OPbagelBites/ECEN404-2026SP-Home-Power-Monitor-2/docs/Drawboard-Combined.docx

Ohm Sweet Home

Joshua Le

Lawson Parr

Kim Peteros

Caiden Rueben

Vivek Samuel

CONCEPT OF OPERATIONS

REVISION – A

September 9, 2025

CONCEPT OF OPERATIONS

FOR

Ohm Sweet Home

TEAM OHM SWEET HOME

APPROVED BY:

_____________________________ Kim Peteros Date _____________________________ Prof. Kalafatis Date _____________________________ Vishwam Raval Date

Concept of Operations Revision - A

Ohm Sweet Home

Change Record

Rev . | Date | Originator | Approvals | Description
1 | 9/9/2025 | Kim Peteros | | Draft Release

2

Concept of Operations Revision - A

Ohm Sweet Home

Table of Contents

Table of Contents.........................................................................................................................3 List of Figures..............................................................................................................................4 1. Executive Summary..........................................................................................................5 1. Introduction....................................................................................................................... 5

1.1. Background......................................................................................................................6 1.2. Overview.......................................................................................................................... 7 1.3. Referenced Documents and Standards............................................................................8

2. Operating Concept............................................................................................................9 2.1. Scope................................................................................................................................ 9 2.2. Operational Description and Constraints................................................................. 11 2.3. System Description.......................................................................................................12 2.4. Modes of Operations................................................................................................... 13 2.5. Users...............................................................................................................................15 2.6. Support...........................................................................................................................17

3. Scenario(s)...................................................................................................................... 18 4. Analysis........................................................................................................................... 20 4.1. Summary of Proposed Improvements...................................................................... 20 4.2. Disadvantages and Limitations...................................................................................21 4.3. Alternatives....................................................................................................................21 4.4. Impact.............................................................................................................................21

3

Concept of Operations Revision - A

Ohm Sweet Home

List of Figures

Figure 1: Home Power Monitor Systems Block Diagram..................................................7 Figure 2: Home Power Monitor Installation......................................................................15

4

Concept of Operations Revision - A

Ohm Sweet Home

1. Executive Summary

The Home Power Monitor is a cost-effective system that provides homeowners with actionable, device-level insights into their electricity usage. As energy costs rise, our solution helps users understand exactly which devices are driving demand. The system integrates five subsystems: an Analog Front End (AFE) to capture electrical signals, a PCB to house the hardware, Digital Signal Processing (DSP) to extract key features, Machine Learning (ML) to identify individual appliances, and a Mobile App for real-time monitoring. By combining precise sensing with advanced analytics, our monitor empowers users to reduce energy waste and lower their utility bills.

1. Introduction

Household electricity consumption drives both utility costs and environmental impact. While most homes have smart meters or utility monitoring, these typically provide only aggregate usage data, offering little insight into which appliances consume the most energy. As a result, opportunities for savings, efficiency, and sustainability often go unrealized.

The Home Power Monitor project addresses this gap by designing a system that measures, analyzes, and classifies energy use at a more granular level. Using affordable sensors, embedded signal processing, machine learning, and a user-friendly app, the system monitors total household consumption and attributes usage to specific devices in near real time.

This interdisciplinary project integrates multiple subsystems: the Analog Front End (AFE) conditions sensor signals, PCB Management combines power and communication hardware, the DSP subsystem extracts features like rms voltage/current, power, and harmonics, and the Machine Learning subsystem identifies devices. Finally, the Application Development subsystem delivers actionable insights through a mobile interface.

Motivated by rising energy costs and sustainability concerns, the Home Power Monitor demonstrates the feasibility of detailed energy monitoring with low-cost components, offering immediate user value and a scalable path toward smart-grid integration.

5

Concept of Operations Revision - A

Ohm Sweet Home

1.1. Background

Current residential energy monitoring is typically limited to whole-home smart meters provided by utility companies. While these devices record total consumption and may allow for daily or hourly breakdowns, they do not provide appliance-level visibility. As a result, users are often left guessing which devices contribute most to their utility bill, reducing the effectiveness of conservation efforts.

Some aftermarket energy monitors exist on the consumer market; however, they are often expensive, closed-source, or rely on proprietary ecosystems that limit flexibility. In addition, many of these products require invasive installation or lack robust analytics, making them inaccessible to the average household.

The Home Power Monitor project is designed to enhance these limitations by delivering a system that is:

● More informative – Using digital signal processing and machine learning, the system provides detailed insights at the device level rather than only whole-home usage.

● More accessible – The design emphasizes low-cost components, a modular PCB, and straightforward installation at the electrical panel.

● More adaptable – By generating standardized JSON data streams and a custom mobile application, the system can evolve beyond monitoring to integrate with future smart home or grid-interactive technologies.

In essence, the proposed project enhances existing monitoring by adding device detection, advanced analytics, and a user-centric interface while replacing the need for costly commercial solutions. It bridges the gap between simple utility data and full smart-home energy management, giving households a practical tool to reduce waste and make informed energy decisions.

6

Concept of Operations Revision - A

Ohm Sweet Home

1.2. Overview

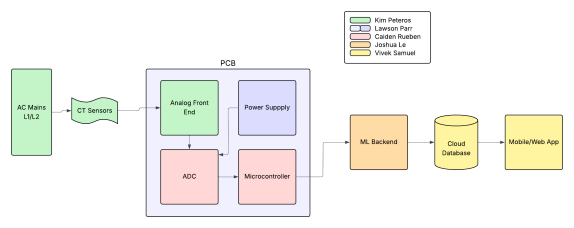
[picture p14: figure]

Figure 1: Home Power Monitor System Block Diagram

The Home Power Monitor is a multidisciplinary system that combines sensing hardware, embedded processing, intelligent analytics, and user-facing software to provide household residents with actionable insight into their energy consumption. The system is organized into five subsystems, Analog Front End (AFE), PCB Management, Digital Signal Processing (DSP), Machine Learning (ML), and Application Development, which work together to deliver accurate data collection, advanced analysis, and a user-friendly interface.

At the foundation of the system, the Analog Front End (AFE) acquires raw current and voltage signals directly from the household electrical panel. Current transformers (CTs) measure line currents, while voltage dividers or isolation sensors capture the corresponding voltage waveforms. These signals are conditioned through filtering, scaling, and isolation circuitry to ensure safety and fidelity before digitization.

The PCB Management subsystem provides the physical integration platform for the project. It consolidates the AFE, microcontroller, power supply, and wireless communication

hardware onto a single, custom-designed printed circuit board. By managing the hardware interconnections, this subsystem ensures reliability, compactness, and scalability. It also simplifies the installation process for end users by housing multiple sensing and processing elements in a single unit.

7

Concept of Operations Revision - A

Ohm Sweet Home

Once the analog signals are digitized, the DSP subsystem takes responsibility for extracting meaningful features. Algorithms implemented on the microcontroller compute metrics such as RMS voltage and current, instantaneous power, real and reactive power, power factor, and harmonic distortion. The DSP subsystem also performs windowing and spectral analysis to capture the load signatures needed for device-level identification. These outputs are structured into JSON-formatted data packets, ensuring consistency for downstream processing and external applications.

The Machine Learning (ML) subsystem processes the feature sets generated by DSP to identify and classify individual appliances. By leveraging training datasets of common load signatures, the ML algorithms can distinguish devices such as refrigerators, HVAC units, or lighting systems, even when they operate simultaneously. Over time, the ML models can be refined and retrained to improve accuracy, adapt to new devices, and accommodate variations in household electrical environments.

The final subsystem, Application Development, focuses on delivering insights to the end user through a mobile or web-based application. This interface displays total household consumption, disaggregated device-level usage, power quality metrics, and historical trends. Users can interact with the data visually through graphs, charts, and notifications, allowing them to identify inefficiencies, track costs, and make informed decisions about their energy usage. The app also serves as the bridge between technical system outputs and practical consumer utility.

Together, these subsystems form a modular yet tightly integrated architecture. The hardware and PCB components enable safe and reliable data collection, the DSP and ML subsystems transform raw measurements into actionable intelligence, and the app development subsystem ensures accessibility and ease of use. This layered approach allows the Home Power Monitor to be more informative, affordable, and adaptable than existing consumer energy monitoring solutions, while maintaining a clear structure that supports future enhancements such as smart-home integration or utility-side data sharing.

1.3. Referenced Documents and Standards

The Home Power Monitor project aligns with relevant electrical, communication, and data standards to ensure safe operation, reliable performance, and interoperability. The following documents and standards have been considered:

● IEEE Standards

○ IEEE Std 1459-2010: Definitions for the Measurement of Electric Power Quantities Under Sinusoidal, Non-Sinusoidal, Balanced, or Unbalanced Conditions.

8

Concept of Operations Revision - A

Ohm Sweet Home

○ IEEE Std 519-2014: Recommended Practice and Requirements for Harmonic Control in Electric Power Systems.

● Electrical Safety Standards

○ NFPA 70 (National Electrical Code): Guidance for safe installation of electrical equipment in residential environments.

○ IEC 61010: Safety requirements for electrical equipment for measurement, control, and laboratory use.

● Communication and Data Standards

○ IEEE 802.11: Wireless LAN (Wi-Fi) communication standard used for transmitting system data.

○ JSON (JavaScript Object Notation): Standardized data format for structured telemetry between subsystems and the mobile application.

● Referenced Project Documents

○ Capstone Team Specification Document (rev. 1.0).

○ Subsystem Requirements and Interface Control Documents (ICDs).

○ Manufacturer datasheets for current transformers, voltage sensors, and microcontroller components.

By adhering to these standards and referencing established documents, the project ensures consistency, safety, and a solid foundation for both prototype development and potential future scalability.

2. Operating Concept

2.1. Scope

The scope of the Home Power Monitor project is to design, build, and demonstrate a prototype system capable of acquiring, processing, classifying, and presenting household electrical usage data at both the total and device levels. The system will be deployed on a residential electrical panel in a controlled demonstration environment and is intended as a proof-of-concept for affordable, scalable home energy monitoring.

9

Concept of Operations Revision - A

Ohm Sweet Home

In-Scope Features:

● Analog Front End (AFE): Measurement of current and voltage waveforms through non-intrusive sensors (e.g., current transformers and voltage dividers) with proper signal conditioning.

● PCB Management: Integration of sensing, processing, power regulation, and wireless communication hardware on a single printed circuit board.

● Digital Signal Processing (DSP): Computation of RMS values, real and reactive power, power factor, harmonic distortion, and other features needed for classification.

● Machine Learning (ML): Identification of appliances through pattern recognition of electrical signatures, with support for adding new devices through a training mode.

● Application Development: A mobile application to display real-time and historical consumption data, device breakdowns, and basic alerts.

Out-of-Scope Features:

● Utility-side integration (e.g., sending data to electric companies or participating in demand-response programs).

● Full-scale commercial productization, including UL certification, enclosure design, or large-scale manufacturing.

● High-voltage electrical work beyond safe CT-based measurement; direct mains wiring is excluded for safety.

● Advanced smart-home automation features (e.g., remotely controlling appliances).

System Boundaries:

The system begins with the measurement of household electrical signals at the panel and ends with visualization of processed results on the user’s mobile application. External systems such as the utility provider’s smart meter or third-party smart-home devices are not part of the current scope but represent potential future extensions.

By defining this scope, the project ensures feasibility within the academic timeline while demonstrating the key functionality of a modern, intelligent home energy monitoring solution.

10

Concept of Operations Revision - A

Ohm Sweet Home

2.2. Operational Description and Constraints

The Home Power Monitor is intended for residential use as a non-intrusive energy monitoring tool. A homeowner, technician, or qualified installer clamps the current transformers (CTs) around the service conductors in the household electrical panel and connects the voltage sensing hardware. Once powered, the system begins acquiring current and voltage waveforms.

The embedded microcontroller processes these signals in real time, calculating standard electrical metrics such as RMS values, real and reactive power, and power factor. These metrics, along with higher-order features such as harmonic distortion, are formatted into JSON packets and transmitted wirelessly.

The machine learning subsystem interprets the extracted features to classify which appliances are operating. This classification, together with aggregate consumption data, is then displayed to the user through the mobile application. The user can interact with the app to view live household consumption, drill down into per-device usage, and review historical energy patterns. In training mode, users can also label new devices, allowing the system to expand its knowledge base.

Constraints:

● Safety: Direct interaction with mains voltage is strictly avoided. CTs and voltage dividers are used to ensure safe, isolated measurements. Installation must comply with standard electrical safety codes (e.g., NEC, IEC).

● Accuracy: Classification accuracy depends on the quality of training data and the distinctiveness of device signatures. Ambiguities may arise when devices with similar load characteristics operate simultaneously.

● Scalability: The prototype is designed for single-home use. Extension to multi-unit dwellings or integration with utility systems is outside the current project scope.

● Resources: Operation is limited by the computational power, memory, and communication bandwidth of the selected microcontroller and wireless modules.

● Environment: The system assumes a stable residential power grid (60 Hz, ~120/240 V). It has not been tested for industrial or three-phase systems. This operational description and the defined constraints ensure that the Home Power Monitor can be used effectively by residential consumers while remaining safe, reliable, and within the scope of an academic prototype.

11

Concept of Operations Revision - A

Ohm Sweet Home

2.3. System Description

The Home Power Monitor system is a modular, multi-subsystem design intended to capture, process, classify, and present residential energy usage data in real time. The system is composed of five primary subsystems—Analog Front End (AFE), PCB Management, Digital Signal Processing (DSP), Machine Learning (ML), and Application Development—that work together to provide an end-to-end energy monitoring solution.

● Analog Front End (AFE):

The AFE acquires raw electrical signals through current transformers and voltage sensors placed at the residential electrical panel. These signals are filtered, isolated, and scaled to safe voltage levels suitable for digitization. The AFE ensures that the quality and safety of measurements are maintained before they are sent downstream.

● PCB Management:

A custom printed circuit board (PCB) integrates the hardware required for sensing, computation, and wireless communication. It houses the microcontroller, analog-to-digital converters (ADCs), power supply regulation, and Wi-Fi/Bluetooth modules. The PCB acts as the central hub, providing reliable connectivity between subsystems while minimizing system footprint.

● Digital Signal Processing (DSP):

Running on the embedded microcontroller, the DSP subsystem processes digitized signals to extract meaningful features. This includes RMS voltage and current, real and reactive power, apparent power, power factor, harmonic distortion, and phase information. The DSP organizes these outputs into structured JSON data packets, enabling interoperability with both the ML subsystem and the application.

● Machine Learning (ML):

The ML subsystem leverages DSP-generated features to classify individual appliances and devices. Using trained load-signature models, it identifies devices operating in the home, flags unknown devices, and supports a training mode for user-labeled additions.

● Application Development:

A mobile application provides the user interface, enabling real-time monitoring, device-level breakdowns, and historical consumption review. Users can also participate in training new devices and receive notifications about unusual loads or inefficiencies.

12

Concept of Operations Revision - A

Ohm Sweet Home

● System-Level Operation:

Signals flow from the electrical panel into the AFE, then through the PCB to the DSP subsystem for feature extraction. Extracted features are interpreted by the ML subsystem to determine device-level activity. Both system-level metrics and device classifications are transmitted wirelessly to the mobile app, where the user interacts with the data. This layered, modular architecture ensures the Home Power Monitor is safe, scalable, and user-centric, while providing a foundation for future enhancements such as smart-grid integration or demand-response applications.

2.4. Modes of Operations

The Home Power Monitor system is designed to support multiple modes of operation, each addressing a specific phase of use or user need. The following modes have been identified:

1. Initialization Mode

○ Occurs when the system is first powered on or reset.

○ The PCB subsystem configures the microcontroller, initializes wireless communication, and verifies sensor connections.

○ A baseline calibration may be performed to ensure measurement accuracy. 2. Normal Monitoring Mode

○ Default operating mode once initialization is complete.

○ The AFE continuously acquires current and voltage signals.

○ The DSP subsystem extracts electrical features and transmits structured data packets to the mobile application.

○ The ML subsystem classifies known appliances in real time.

○ The mobile app presents aggregate and per-device usage to the user. 3. Learning / Training Mode

○ Activated when a new or unrecognized device is detected.

○ The ML subsystem temporarily records load signatures over several on/off cycles.

13

Concept of Operations Revision - A

Ohm Sweet Home

○ The user labels the device through the mobile app.

○ The new signature is added to the device classification library for future recognition.

4. Historical Analysis Mode

○ Provides review of past consumption data through the mobile app.

○ Users can examine daily, weekly, or monthly trends, compare device usage over time, and identify long-term inefficiencies.

○ Data is retrieved from local storage or app-side databases.

5. Error / Safe Mode

○ Entered if the system encounters abnormal operating conditions (e.g., sensor fault, communication loss, or power anomaly).

○ In this mode, data collection is paused, the system maintains a safe idle state, and the user is notified through the app.

○ These operational modes ensure that the Home Power Monitor is not only capable of providing real-time insights, but also adaptable to new devices, useful for long-term tracking, and resilient to system errors.

14

Concept of Operations Revision - A

Ohm Sweet Home

2.5. Users

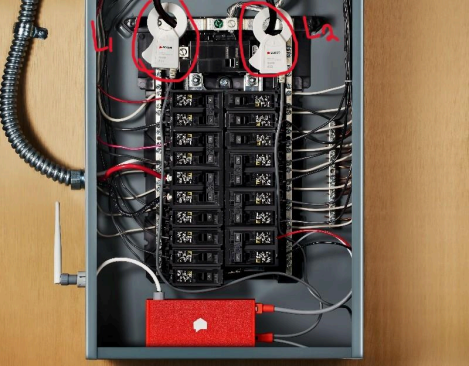
[picture p15: figure]

Figure 2: Home Power Monitor Installation

The Home Power Monitor is designed primarily for residential consumers but involves different types of users across its lifecycle.

1. Homeowners / Residents (Primary End Users):

○ Role: Interact with the mobile application to monitor real-time energy use, view appliance-level breakdowns, and review historical data.

○ Characteristics:

■ Minimal technical training required; app interface is designed to be intuitive.

15

Concept of Operations Revision - A

Ohm Sweet Home

■ Expected to use the system casually (checking daily usage, monitoring large appliances, etc.).

■ Benefit from reduced energy costs, increased awareness of

consumption, and improved ability to adopt sustainable practices.

2. Installers / Technically Skilled Users:

○ Role: Perform the initial installation of current transformers (CTs) and voltage sensors at the household electrical panel.

○ Characteristics:

■ Moderate electrical knowledge required to ensure safe and

code-compliant installation.

■ Could include electricians, technically inclined homeowners, or team members during demonstration.

■ Ensure sensors are properly clamped and PCB hardware is powered safely.

○ Training Needs: A brief installation guide or safety sheet is sufficient for qualified personnel.

3. Secondary Beneficiaries:

○ Academic Team / Developers: The student team benefits from the project as a learning and design exercise in integrating hardware, DSP, ML, and app development.

○ Future Utility Providers or Researchers: Although not part of this prototype’s immediate scope, energy companies or research groups could benefit from the framework by adapting it for broader smart-grid or

demand-response applications.

Summary:

The primary users require little to no training beyond app usage, while installation requires moderate technical skill. The system ultimately benefits homeowners by providing actionable insight into energy consumption, with potential secondary benefits to researchers and future commercial adopters.

16

Concept of Operations Revision - A

Ohm Sweet Home

2.6. Support

Support for the Home Power Monitor system will be delivered through a combination of documentation, training materials, and technical assistance, ensuring that both installation and ongoing use are accessible to the intended user base.

1. User Documentation:

○ A User Manual will be provided, detailing system setup, safe installation practices, and step-by-step instructions for connecting sensors, powering the unit, and pairing the mobile application.

○ The manual will also include troubleshooting guides for common issues such as connectivity failures, app synchronization problems, or inaccurate

readings.

○ Clear safety warnings will emphasize that installation around electrical panels should be performed by qualified individuals.

2. Technical Documentation:

○ A Technical Reference Guide will be available for advanced users, developers, or future teams. This will include subsystem block diagrams, firmware structure, JSON data formats, and machine learning training workflows.

○ PCB schematics, parts lists, and sensor datasheets will be archived for reproducibility and maintenance.

3. Training Materials:

○ Quick-start guides and visual aids (diagrams, annotated photos) will simplify installation and system initialization.

○ Video demonstrations may be developed for classroom or user-friendly instruction.

4. Technical Support:

17

Concept of Operations Revision - A

Ohm Sweet Home

○ During the capstone project, technical support will be provided directly by the student development team. Users experiencing issues can rely on team members for troubleshooting and updates.

○ In a commercial deployment, support would expand to include dedicated email or phone support channels, online FAQs, and periodic firmware/app updates.

Summary:

By combining clear documentation, practical training materials, and responsive technical assistance, the Home Power Monitor ensures that both homeowners and technically skilled installers have the resources necessary to use the system safely, effectively, and with confidence.

3. Scenario(s)

3.1 Scenario Name #1 – Real-Time Monitoring of Household Energy

In this scenario, a homeowner installs the Home Power Monitor system at their main electrical panel and uses the companion mobile app to observe energy usage.

1. Setup and Initialization

○ The user powers on the Home Power Monitor device after installation.

○ The device begins acquiring current and voltage signals from the AFE subsystem.

○ The PCB subsystem digitizes the conditioned signals and provides them to the DSP subsystem.

2. Data Processing

○ The DSP subsystem calculates RMS voltage, RMS current, real power, reactive power, and power factor for each measurement frame.

○ JSON-formatted packets are generated and transmitted wirelessly to the mobile application.

3. Machine Learning Classification

18

Concept of Operations Revision - A

Ohm Sweet Home

○ The ML subsystem receives extracted features from the DSP and applies trained models to classify active devices.

○ If multiple devices are operating simultaneously, the subsystem separates their signatures and labels them individually.

4. User Interaction

○ The mobile application displays real-time household consumption, breaking down usage by device.

○ The user can toggle between real-time and historical views to identify patterns (e.g., HVAC consumption spikes at certain times of day).

○ Notifications may alert the user if unusual loads are detected, such as a device running longer than normal.

Outcome:

The homeowner gains clear, actionable visibility into their household energy usage. They can see which devices are consuming the most power, recognize inefficiencies, and make informed decisions to reduce energy costs.

3.2 Scenario Name #2 – Device Training and Learning Mode

In this scenario, a homeowner introduces a new appliance into the household (e.g., a space heater) and the Home Power Monitor adapts to recognize it in future operation.

1. Setup and Device Operation

○ The user powers on the new appliance while the Home Power Monitor is active.

○ The AFE subsystem senses the electrical load signature from the appliance and conditions the signals for digitization.

2. Data Acquisition and Processing

○ The PCB subsystem digitizes the conditioned signals and passes them to the DSP subsystem.

19

Concept of Operations Revision - A

Ohm Sweet Home

○ DSP algorithms calculate RMS values, instantaneous power, harmonic distortion, and transient characteristics unique to the new device.

3. Machine Learning Adaptation

○ The ML subsystem initially classifies the load as “unknown” since it does not match any trained device signature.

○ The system enters a learning mode where it records the device’s operational features over multiple on/off cycles.

○ The recorded signatures are stored in the local training dataset and associated with a user-provided label (e.g., “Space Heater”).

4. User Interaction

○ Through the mobile application, the system prompts the user to confirm or name the newly detected device.

○ The app provides a guided workflow, showing when to power the device on and off to capture sufficient training data.

○ Once training is complete, the device appears in the app’s monitored device list.

Outcome:

The Home Power Monitor successfully adapts to recognize new appliances without requiring manual recalibration of the hardware or software. From this point onward, the system can automatically identify and track the space heater’s energy consumption in both real-time and historical views.

4. Analysis

4.1. Summary of Proposed Improvements

● The system improves user privacy by performing initial analysis on the device, minimizing the cloud data transfer required by competitors.

● By using a custom Analog Front End and modern ML models, the system is designed for higher accuracy and faster appliance identification.

20

Concept of Operations Revision - A

Ohm Sweet Home

● A local-first approach creates the possibility for an offline mode and direct smart home integrations, giving users true data ownership.

● The mobile app will focus on providing clear, actionable recommendations by directly linking energy consumption to its monetary cost.

4.2. Disadvantages and Limitations

● The system requires professional installation by an electrician, which adds a significant cost and logistical barrier for users.

● The ML model will have inherent limitations in identifying unseen, variable-state, or concurrently running appliances.

● A custom hardware design with more powerful onboard processing may lead to a higher retail price than simpler alternatives.

● While some processing is local, the full user experience still depends on a reliable Wi-Fi connection and the availability of the cloud backend.

4.3. Alternatives

● Individual smart plugs offer perfect accuracy for monitored devices but cannot provide a whole-home solution or monitor hard-wired appliances.

● Using utility smart meter data is free but has a very low resolution, making it unsuitable for real-time monitoring or appliance identification.

● Per-circuit monitors offer more granularity than a single sensor but are more complex to install and cannot distinguish between multiple devices on the same circuit.

4.4. Impact

● The system aims to reduce a home's carbon footprint by encouraging energy savings, though the device itself has an environmental cost from manufacturing and e-waste.

● It promotes financial savings and energy literacy but risks creating a "green divide" where benefits are mainly accessible to higher-income households.

● The primary ethical concern is user privacy, which is addressed through a local-first processing architecture and robust data security measures.

21

Ohm Sweet Home

Joshua Le

Lawson Parr

Kim Peteros

Caiden Rueben

Vivek Samuel

INTERFACE CONTROL DOCUMENT

REVISION – B

September 21, 2025

INTERFACE CONTROL DOCUMENT

FOR

Ohm Sweet Home

PREPARED BY:

_____________________________ Author Date

APPROVED BY:

_____________________________ Project Leader Date

_____________________________ John Lusher II, P.E. Date

_____________________________ T/A Date

Interface Control Document Revision - B

Ohm Sweet Home

Change Record

Rev . | Date | Originator | Approvals | Description
B | 9/21/2025 | Lawson Parr | Kim Peteros | ICD

2

Interface Control Document Revision - B

Ohm Sweet Home

Table of Contents

1. Overview 5 Figure 1: Block Diagram 5 2. References and Definitions 6 2.1. References 6 2.2. Definitions 6 3. Physical Interface 7 3.1. Weight 7 3.2. Dimensions 7 3.3. Mounting Locations 7 4. Thermal Interface 8 5. Electrical Interface 8 5.1. Primary Input Power 8 5.2. Polarity Reversal 9 5.3. Signal Interfaces 9 5.3.1. Analog Sensor Inputs 9 5.3.2. ADC to MCU (Digital Interface) 9 5.3.3. Power and Grounding 10 5.4. Video Interfaces 10 5.5. User Control Interface 10 6. Communications / Device Interface Protocols 10 6.1. Wireless Communications (Wi-Fi) 10

Each packet is timestamped and transmitted to either a local network server or the mobile app via HTTP or MQTT protocol. 10 6.2. Host Device 11 6.3. Video Interface 11 6.4. Device Peripheral Interface 11

3

Interface Control Document Revision - B

Ohm Sweet Home

List of Tables

Table 1: Reference Documents 6 Table 2: Definitions 7 Table 3: Power Specifications 8 Table 4: ADC Input Characteristics 9 Table 5: Digital Interface Specifications 10 Table 6: Wi_Fi Specifications 11 Table 7: PIN Assignment 11

4

Interface Control Document Revision - B

Ohm Sweet Home

List of Figures

Figure 1: Block Diagram 5 1. Overview

The Interface Control Document (ICD) defines the physical, electrical, and communication interfaces between all subsystems of the Home Power Monitor. This document ensures compatibility and consistency between the Analog Front End (AFE), the ADC (ADS131M04), the embedded microcontroller (ESP32), and higher-level software layers (Machine Learning and Mobile Application).

The ICD covers signal-level characteristics, pin definitions, power and grounding requirements, data communication protocols, and mechanical constraints. It ensures that every subsystem can be developed independently while maintaining integration compatibility at the system level.

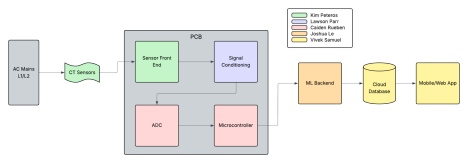
[picture p16: figure]

Figure 1: Block Diagram

5

Interface Control Document Revision - B

Ohm Sweet Home

2. References and Definitions

2.1. References

Reference | Description | Date
TI ADS131M04 Datasheet | 24-bit, 4-channel delta-sigma ADC used for simultaneous sampling | 2023
Espressif ESP32 Technical Reference Manual | Microcontroller hardware and Wi-Fi architecture | 2022
IEEE 802.11 Standard | Wi-Fi protocol for data transmission to mobile app | 2021
JSON Data Schema | Standardized data format used between DSP and App subsystems | 2024
NFPA 70 (NEC) | Residential electrical safety requirements | 2023
Home Power Monitor FSR | Functional System Requirements document defining performance specs 2025

Table 1: Reference Documents

2.2. Definitions

Term | Definition
AFE | Analog Front End; circuits that scale, filter, and isolate AC signals
ADC | Analog-to-Digital Converter; converts analog voltages to digital samples
CT | Current Transformer used for non-invasive current sensing
SPI | Serial Peripheral Interface; synchronous serial link between ADC and MCU
Wi-Fi JSON | Wireless communication based on IEEE 802.11 standard JavaScript Object Notation; lightweight data-interchange format
MCU | Microcontroller Unit (ESP32)

6

Interface Control Document Revision - B

Ohm Sweet Home

RMS | Root Mean Square measurement for voltage and current
THD | Total Harmonic Distortion
GND | Electrical system ground reference
VREF | ADC voltage reference, used to normalize input ranges

Table 2: Definitions

3. Physical Interface

Provide details on the physical interface. Examples are:

3.1. Weight

The complete Home Power Monitor system, including PCB, enclosure, and connectors, shall have a total mass not exceeding 1.0 kg (2.2 lb).

Rationale: Ensures a compact, wall-mountable unit that can be safely installed near a household breaker panel.

3.2. Dimensions

The integrated PCB assembly measures approximately 8 in × 6 in × 2 in.

● AFE and ADC are located on the analog section of the board, isolated by a split ground plane.

● ESP32 module, Wi-Fi antenna, and power regulation components occupy the digital section.

● External CT and voltage sense connectors are accessible from the enclosure front panel.

7

Interface Control Document Revision - B

Ohm Sweet Home

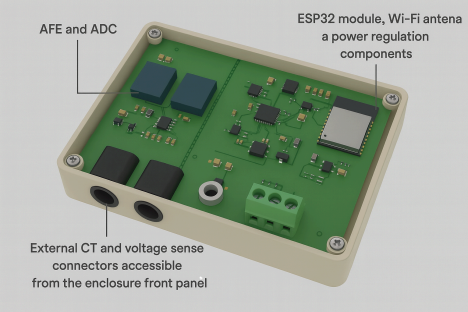
[picture p17: figure]

Figure 1: PCB 3D Model

3.3. Mounting Locations

The Home Power Monitor shall be mounted on a vertical surface adjacent to the main electrical panel using two #8 mounting screws spaced 4 in apart. The CT leads and voltage sense lines shall be routed through grommeted input holes to maintain electrical isolation and strain relief.

4. Thermal Interface

The Home Power Monitor operates under passive cooling.

● Power dissipation across the ESP32 and ADC is below 2 W total, which produces minimal thermal load.

● Copper pour and thermal vias on the PCB act as heat spreaders for the ESP32 and voltage regulators.

● Ventilation holes on the enclosure shall allow convective airflow in ambient conditions up to 50 °C.

8

Interface Control Document Revision - B

Ohm Sweet Home

● No active cooling (fans) or cold walls are required.

Rationale: Maintaining low component temperature improves measurement accuracy and reliability of the ADC reference voltage.

5. Electrical Interface

5.1. Primary Input Power

Parameter | Specification | Notes
Input Voltage | 5 V DC ±5 % | Supplied from USB-C wall adapter or regulated DC supply
Current Draw | ≤ 400 mA peak | During Wi-Fi transmission bursts
Power Consumption | ≤ 2 W total | Includes AFE, ADC, and MCU subsystems
Regulation | Onboard 3.3 V LDO regulator | Provides MCU and ADC rail
Ground | Single digital/analog star ground | Prevents ground loops and noise injection

Table 3: Power Specifications

The 5 V rail powers the ESP32 via its onboard regulator and provides 3.3 V to the ADS131M04 and op-amp buffer circuits.

5.2. Polarity Reversal

Reverse-polarity protection is provided via a Schottky diode on the input supply rail. This prevents damage if the power connector is wired incorrectly.

5.3. Signal Interfaces

The Home Power Monitor uses several critical analog and digital interfaces.

5.3.1. Analog Sensor Inputs

Signal | Source | Destination | Nominal Range | Description
I_SENSE | CT burden resistor output | AFE-Interface → ADC CH1 | ±1.5 V pk | Represents line current waveform

9

Interface Control Document Revision - B

Ohm Sweet Home

V_SENSE | Voltage divider output | AFE-Interface → ADC CH1 | ±1.5 V pk | Represents line voltage waveform
REF_MID | AFE-Interface bias voltage | ADC reference input | 1.65 V DC | Mid-rail bias for AC-coupled signals

Table 4: ADC Input Characteristics

Characteristics:

● Bandwidth: 0 – 2 kHz (anti-alias filtered).

● Differential input configuration used to improve noise immunity.

● Coupled through unity-gain buffer op-amps.

5.3.2. ADC to MCU (Digital Interface)

Parameter | Value | Description
Protocol | SPI (Serial Peripheral Interface) | 4-wire, full duplex
Clock Frequency | 4 MHz | SCLK generated by ESP32 master
Data Word Length | 24 bits × 4 channels | Synchronized multi-channel sampling
Chip Select | GPIO15 (configurable) | ADC enable signal
DRDY (Data Ready) | GPIO4 | ADC data-ready interrupt pin
VIO | 3.3 V | Logic level for both devices

Table 5: Digital Interface Specifications

Rationale: SPI communication provides deterministic timing for synchronized current and voltage sampling.

5.3.3. Power and Grounding

● Analog Ground (AGND) is shared among AFE, ADC reference, and op-amp circuitry. ● Digital Ground (DGND) serves MCU logic, Wi-Fi, and USB power domains.

● The two planes are connected at a single star point near the ADC to minimize noise coupling.

5.4. Video Interfaces

Not applicable to this system. The Home Power Monitor performs numerical and graphical data visualization exclusively through the mobile app interface.

10

Interface Control Document Revision - B

Ohm Sweet Home

5.5. User Control Interface

The ESP32 includes a Reset Button, a Status LED, and an optional Config Mode Button for Wi-Fi pairing.

● The LED indicates power, Wi-Fi connection, and fault status via color/blink pattern.

● In configuration mode, the ESP32 hosts a local web portal for network setup (SSID, password).

6. Communications / Device Interface Protocols 6.1. Wireless Communications (Wi-Fi)

Each packet is timestamped and transmitted to either a local network server or the mobile app via HTTP or MQTT protocol.

Parameter | Specification
Standard | IEEE 802.11 b/g/n
Frequency Band | 2.4 GHz
Security | WPA2-PSK
Typical Data Rate | 1–2 Hz JSON packet transmission
JSON Schema | {t, rms_v, rms_i, p, s, pf, thd, harmonics

Table 6: Wi_Fi Specifications

Rationale: Wi-Fi communication provides low-latency, high-throughput telemetry within standard residential environments.

6.2. Host Device

The Host Device for the Home Power Monitor is the user’s smartphone or web dashboard, which receives telemetry through the app interface.

● The App visualizes live voltage, current, power factor, and device classification results.

● It can send configuration commands (Wi-Fi credentials, calibration updates) back to the ESP32 via REST API endpoints.

11

Interface Control Document Revision - B

Ohm Sweet Home

Example REST Structure:

POST /config {“ssid”:“home_wifi”, “password”:“mypassword”} GET /telemetry returns latest JSON frame.

6.3. Video Interface

Not applicable. The Home Power Monitor transmits numerical data only.

6.4. Device Peripheral Interface

The Home Power Monitor uses UART for debugging and SPI for ADC communication.

Interface | Pins | Baud/Clock | Description
UART0 | TX=GPIO1, RX=GPIO3 | 115200 bps | Used for firmware upload and debugging
SPI | MISO=GPIO19, MOSI=GPIO23, SCLK=GPIO18 | 4 MHz | High-speed data transfer from ADS131M04

Table 7: PIN Assignment

Rationale: Provides reliable development and debugging interfaces while maintaining isolation from production data paths.

12

Ohm Sweet Home

Joshua Le

Lawson Parr

Kim Peteros

Caiden Rueben

Vivek Samuel

FUNCTIONAL SYSTEM REQUIREMENTS

REVISION – B

September 21, 2025

FUNCTIONAL SYSTEM REQUIREMENTS

FOR

Ohm Sweet Home

PREPARED BY:

_____________________________

Author Date

APPROVED BY:

_____________________________

Kim Peteros Date

_____________________________

John Lusher, P.E. Date

_____________________________

T/A Date

Functional System Requirements Revision - B

Ohm Sweet Home

Change Record

Rev . | Date | Originator | Approvals | Description
B | 9/21/2025 | Caiden Rueben | Kim Peteros | FSR

2

Functional System Requirements Revision - B

Ohm Sweet Home

Table of Contents

1. Introduction 6 1.1. Purpose and Scope 6 1.2. Responsibility and Change Authority 7

2. Applicable and Reference Documents 8 2.1. Applicable Documents 8 2.2. Reference Documents 8 2.3. Order of Precedence 9

3. Requirements 9 3.1. System Definition 9 3.2. Characteristics 10

3.2.1. Functional / Performance Requirements 10 3.2.2. Physical Characteristics 11 3.2.3. Electrical Characteristics 11 3.2.4. Environmental Requirements 12 3.2.5. Failure Propagation 12

5. Support Requirements 13 Appendix A – Acronyms and Abbreviations 14 Appendix B: Definition of Terms 14

3

Functional System Requirements Revision - B

Ohm Sweet Home

List of Tables

Table 1: System Subleads 7 Table 2: Applicable Documents 8 Table 3: Reference Document 8 Table 4: Environmental Requirements 12

4

Functional System Requirements Revision - B

Ohm Sweet Home

List of Figures

Figure 1. Your Project Conceptual Image 6 Figure 2. Block Diagram of System 9

5

Functional System Requirements Revision - B

Ohm Sweet Home

1. Introduction

1.1. Purpose and Scope

The Home Power Monitor is a modular system designed to provide residential users with real-time visibility into their household electricity usage. By combining precision analog sensing, embedded signal processing, machine learning, and a mobile interface, the system delivers detailed, device-level energy analytics without requiring expensive commercial smart meters or invasive wiring.

The purpose of this document is to define the technical and functional requirements for the Home Power Monitor and its subsystems. It specifies performance, physical, electrical, environmental, and reliability expectations to guide design, testing, and integration. This specification applies to all development items and subsystems that make up the Home Power Monitor, including the Analog Front End (AFE), Printed Circuit Board (PCB), Digital Signal Processing (DSP), Machine Learning (ML), and Application (App) subsystems.

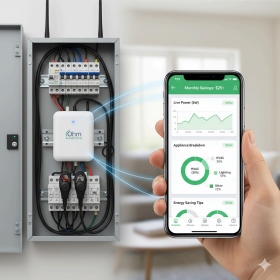
[picture p18: figure]

Figure 1. Your Project Conceptual Image

6

Functional System Requirements Revision - B

Ohm Sweet Home

1.2. Responsibility and Change Authority

The project leader (Kim Peteros) is responsible for ensuring that all requirements outlined in this document are met during development. Any modifications to the system requirements must be approved by both the project leader and the supervising faculty advisor (Prof. Stavros Kalafatis).

Subsystem | Responsibility | Owner
AFE-Sense (Current/Voltage Sensing) | Signal acquisition and safety isolation | Kim Peteros
AFE-Interface (Signal Conditioning) | Biasing, buffering, filtering, and ADC drive | Lawson Parr
Embedded Systems (DSP) | Data acquisition, signal processing, and feature extraction | Caiden Rueben
Machine Learning | Load classification and model training | Joshua Le
Application Development | Data visualization, user interaction, and telemetry | Vivek Samuel

Table 1: System Subleads

7

Functional System Requirements Revision - B

Ohm Sweet Home

2. Applicable and Reference Documents

2.1. Applicable Documents

The following standards and documents are applicable to the design, fabrication, and operation of the Home Power Monitor:

Document Number | Revision/Release Date | Document Title
IEEE Std 1459–2010 | 2010 | Definitions for the Measurement of Electric Power Quantities
IEEE Std 519–2014 | 2014 | Recommended Practice for Harmonic Control in Electric Power Systems
NFPA 70 | 2023 | National Electrical Code (NEC) – Residential Electrical Safety
IEC 61010 | 2019 | Safety Requirements for Electrical Equipment for Measurement, Control, and Laboratory Use
IEEE 802.11 | 2021 | Wireless LAN (Wi-Fi) Communication Standard
JSON Schema | 2024 | Data Interchange Format Specification
IPC A-610E | 2010 | Acceptability of Electronic Assemblies

Table 2: Applicable Documents

2.2. Reference Documents

The following documents provide additional guidance used during system development:

Document Number | Revision/Release Date | Document Title
TI ADS131M04 | 2021 | Delta-Sigma ADC used for precision voltage/current sampling
ESP32 Technical Reference Manual | 2016 | Microcontroller architecture and ADC control
Home Power Monitor CONOPS | 2025 | Concept of Operations defining system scope and flow
Team ICD (in progress) | 2025 | Interface Control Document outlining signal and data pathway

Table 3: Reference Document

8

Functional System Requirements Revision - B

Ohm Sweet Home

2.3. Order of Precedence

In the event of a conflict between the text of this specification and an applicable document cited herein, the text of this specification takes precedence without any exceptions.

All specifications, standards, exhibits, drawings or other documents that are invoked as “applicable” in this specification are incorporated as cited. All documents that are referred to within an applicable report are considered to be for guidance and information only, except ICDs that have their relevant documents considered to be incorporated as cited.

3. Requirements

This section defines the minimum requirements that the development item(s) must meet. The requirements and constraints that apply to performance, design, interoperability, reliability, etc., of the system, are covered.

3.1. System Definition

The Home Power Monitor system measures, processes, and classifies household electrical signals to provide actionable feedback to users.

Figure 2. Block Diagram of System

The system is divided into the following subsystems:

● AFE-Sense: Captures high-voltage (120/240 V) and high-current (0–40 A RMS) mains signals through isolated current transformers and voltage dividers.

● AFE-Interface: Conditions, filters, and level-shifts the sensor outputs into 0–3.3 V signals for the ADC.

9

Functional System Requirements Revision - B

Ohm Sweet Home

● Embedded Systems (DSP): Digitizes, processes, and extracts features such as RMS voltage, RMS current, real/reactive power, THD, and harmonic content using the ESP32 and TI ADS131M04 ADC.

● Machine Learning: Classifies individual appliances based on their electrical signatures using trained models.

● Application Development: Displays live and historical power metrics, alerts, and classification results via a mobile or web interface.

3.2. Characteristics

3.2.1. Functional / Performance Requirements

3.2.1.1. Requirement #1

The Home Power Monitor shall measure RMS voltage and RMS current with a maximum error of ±2%.

Rationale: Ensures energy readings remain consistent with typical residential-grade metering accuracy.

3.2.1.2. Search Probability of Detection

The DSP subsystem shall acquire synchronized current and voltage samples at 4.096 kHz with frame lengths of 1024 samples per window.

Rationale: Provides sufficient frequency resolution (~4 Hz) for harmonic analysis while maintaining real-time processing capability.

3.2.1.3. Operational Search Altitude

The DSP subsystem shall compute real power (P), reactive power (Q), apparent power (S), and power factor (pf) for each frame.

Rationale: Core energy metrics required by the ML and App subsystems.

3.2.1.4 Harmonic Analysis

The DSP subsystem shall perform a discrete Fourier transform (DFT/FFT) on each window to extract at least the 2nd, 3rd, and 5th harmonics.

Rationale: Harmonic information aids in identifying nonlinear loads and provides input for ML classification.

3.2.1.5 Communication and Data Packaging

The ESP32 shall package each processed frame into a JSON object using the schema: {t, rms_v, rms_i, p, s, pf, thd, harmonics}

and transmit it over Wi-Fi at a minimum rate of 1 Hz.

Rationale: Ensures compatibility across ML and App interfaces.

10

Functional System Requirements Revision - B

Ohm Sweet Home

3.2.1.6 Classification Accuracy

The ML subsystem shall identify trained appliances with ≥85% accuracy under nominal load conditions.

Rationale: Acceptable performance threshold for prototype demonstrations given dataset variability.

3.2.1.7 System Latency

Total end-to-end latency from signal acquisition to app display shall not exceed 3 seconds. Rationale: Maintains the appearance of “real-time” monitoring for the user interface.

3.2.2. Physical Characteristics

3.2.2.1 Size and Mounting

The full Home Power Monitor unit (PCB enclosure) shall not exceed 8 in × 6 in × 2 in and shall mount inside or adjacent to a residential breaker panel.

Rationale: Allows compact, low-profile installation within standard utility closets.

3.2.2.2 Weight

Total system mass shall not exceed 1 kg (2.2 lb).

Rationale: Ensures safe, convenient installation and reduces mechanical stress on panel surfaces.

3.2.2.3 PCB Integration

All subsystems (AFE, ADC, ESP32, and power regulation) shall be integrated onto a single custom PCB.

Rationale: Simplifies assembly, improves signal integrity, and ensures modular scalability. 3.2.3. Electrical Characteristics

3.2.3.1 Input Signals

A) Voltage input: up to 240 V RMS (stepped down to <2 V pk).

B) Current input: up to 40 A RMS per line (stepped down to <2 V pk). Rationale: Matches residential single-phase electrical systems while

remaining within ADC input limits.

3.2.3.2 Power Supply

The Home Power Monitor shall operate from a 5 V DC input at ≤2 W total power. Rationale: Compatible with USB or wall-adapter power sources, ensuring energy efficiency.

3.2.3.3 ADC Resolution and Input Range

The ADS131M04 ADC shall operate at 24-bit resolution with differential input range ±2.4 V and sampling rate 4.096 kHz per channel.

Rationale: Ensures precise, low-noise signal capture for accurate analysis. 11

Functional System Requirements Revision - B

Ohm Sweet Home

3.2.3.4 Grounding and Isolation

The system shall maintain electrical isolation between the high-voltage mains inputs and low-voltage digital circuits through CT isolation and resistive voltage dividers. Rationale: Protects users and electronics from dangerous line voltages.

3.2.3.5 Communication Interface

The ESP32 shall interface with the ADS131M04 via SPI and with the mobile app via Wi-Fi (IEEE 802.11b/g/n).

Rationale: Provides reliable high-speed local communication and wireless telemetry.

3.2.3.6 Input Protection

All sensor inputs shall include overvoltage clamps and TVS diodes rated for expected transients up to ±5 V.

Rationale: Prevents ADC or MCU damage during surge events or disconnection.

3.2.4. Environmental Requirements

The Home Power Monitor shall operate under normal residential indoor conditions:

Parameters | Range | Rationale
Temperature | 0 °C – 50 °C | Expected range near electrical panels
Humidity | 10% – 90% RH non-condensing | Typical household environment
Altitude | 0 – 2000 m | Consistent with indoor consumer devices

Table 4: Environmental Requirements

The device enclosure shall provide basic dust protection (minimum IP2X). Rationale: Ensures reliable operation without requiring full industrial hardening.

3.2.5. Failure Propagation

3.2.5.1 Fault Isolation

The Home Power Monitor shall not allow electrical faults from the AFE to propagate into the ADC or MCU circuits.

Rationale: Prevents cascading subsystem failures due to overvoltage or short conditions.

3.2.5.2 Failure Detection, Isolation, and Recovery (FDIR)

The system shall perform a self-check sequence at startup to verify ADC communication, Wi-Fi connectivity, and sensor presence.

12

Functional System Requirements Revision - B

Ohm Sweet Home

3.2.5.2.1 Built-In Test (BIT)

The BIT shall detect ADC disconnection, data stream corruption, or failed sampling synchronization in 95% of occurrences. Rationale: Provides diagnostic confidence during field setup.

3.2.5.2.2 BIT False Alarm Rate

The BIT shall not falsely report a fault more than 5% of the time.

Rationale: Prevents unnecessary troubleshooting.

3.2.5.2.3 BIT Log

The BIT shall store the last 10 error events in flash memory for retrieval through the app. Rationale: Enables debugging and reliability tracking.

3.2.5.2.4 System Recovery

Upon fault detection, the MCU shall attempt one automatic reset before requiring user intervention.

Rationale: Improves uptime and reduces manual restarts during testing. 5. Support Requirements

The Home Power Monitor system requires minimal user support after installation. 1. Documentation:

○ A user manual will provide step-by-step installation and safety instructions.

○ A technical appendix will describe subsystem connections, JSON schema, and calibration steps.

2. Software Updates:

○ The ESP32 firmware and mobile app shall support over-the-air (OTA) updates.

3. Technical Support:

○ During Capstone testing, the student team provides direct support and maintenance.

○ In future versions, support may include online troubleshooting and firmware patch notes.

4. Training Materials:

○ Quick-start videos or diagrams to assist with safe CT installation and Wi-Fi pairing.

13

Functional System Requirements Revision - B

Ohm Sweet Home

Appendix A – Acronyms and Abbreviations

Acronym | Definition
ADC | Analog-to-Digital Converter
AFE | Analog Front End
BIT | Built-In Test
CT | Current Transformer
DFT | Discrete Fourier Transform
DSP | Digital Signal Processing
FFT | Fast Fourier Transform
ML | Machine Learning
PCB | Printed Circuit Board
PF | Power Factor
RMS | Root Mean Square
THD | Total Harmonic Distortion
TVS | Transient Voltage Suppression
Wi-Fi | Wireless Fidelity

Table 5: Acronyms and Abbreviations

Appendix B: Definition of Terms

Frame:

A collection of samples processed as one analysis window (N = 1024).

Feature Set:

Collection of calculated electrical quantities used for ML classification.

Load Signature:

The distinct electrical behavior (current, harmonic, and phase pattern) of a device under operation.

14

Ohm Sweet Home Joshua Le

Lawson Parr

Kim Peteros

Caiden Rueben

Vivek Samuel

Execution Schedule/Plan

Execution Schedule for Home Power Monitor 2

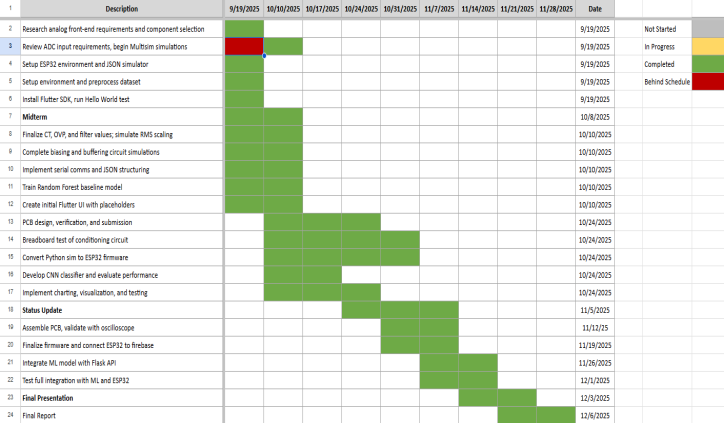
[picture p19: figure]

Project Execution

Work | End Date | Owner | Status | Date Completed
CONOPS | 9/17/25 | All | ✅ Complete | 9/14/25
FSR | 10/4/25 | All | ✅ Complete | 10/4/25
ICD | 10/4/25 | All | ✅ Complete | 10/4/2025
Midterm Presentation | 10/8/25 | All | ✅ Complete | 10/8/25
Subsystem 1 (AFE) — Research analog front-end requirements and component selection | 10/10/25 | Kim Peteros | ✅ Complete | 10/9/2025
Subsystem 2 (PCB) — Review ADC input requirements, begin SPICE simulations | 10/10/25 | Lawson Parr | ✅ Complete | 10/10/2025
Embedded Systems — Setup ESP32 environment and JSON simulator | 10/10/25 | Caiden Rueben | ✅ Complete | 10/8/2025
Machine Learning — Setup environment and preprocess dataset | 10/10/25 | Joshua Le | ✅ Complete | 10/9/2025
App Development — Install Flutter SDK, run Hello World test | 10/10/25 | Vivek Samuel | ✅ Complete | 10/8/2025
Status/Progress Update 1 | 10/10/25 | All | ✅ Complete | 10/24/25
Subsystem 1 — Finalize CT, OVP, and filter values; simulate RMS scaling | 10/24/25 | Kim Peteros | ✅ Complete | 10/20/25
Subsystem 2 — Complete biasing and buffering circuit simulations | 10/24/25 | Lawson Parr | ✅ Complete | 10/18/25
Embedded Systems — Implement serial comms and JSON structuring | 10/24/25 | Caiden Rueben | ✅ Complete | 10/22/2025
Machine Learning — Train Random Forest baseline model | 10/24/25 | Joshua Le | ✅ Complete | 10/22/2025
App Development — Create initial Flutter UI with placeholders | 10/24/25 | Vivek Samuel | ✅ Complete | 10/21/2025

Progress Update 2 | 10/24/25 | All | ✅ Complete | 11/7/25
Subsystem 1 — PCB design, verification, and submission | 11/7/25 | Kim Peteros | ✅ Complete | 11/2/25
Subsystem 2 — Breadboard test of conditioning circuit | 11/7/25 | Lawson Parr | ✅ Complete | 11/4/25
Embedded Systems — Convert Python sim to ESP32 firmware | 11/7/25 | Caiden Rueben | ✅ Complete | 11/5/2025
Machine Learning — Develop CNN classifier and evaluate performance | 11/7/25 | Joshua Le | ✅ Complete | 11/6/2025
App Development — Implement charting, visualization, and testing | 11/7/25 | Vivek Samuel | ✅ Complete | 11/4/2025
Progress Update 3 | 11/7/25 | All | ✅ Complete | 11/21/25
Subsystem 1 — Assemble PCB, validate with oscilloscope | 11/21/25 | Kim Peteros | ✅ Complete | 11/21/2025
Subsystem 2 — Assemble PCB and confirm signal integrity | 11/21/25 | Lawson Parr | ✅ Complete | 11/19/2025
Embedded Systems — Finalize firmware and verify JSON streaming | 11/21/25 | Caiden Rueben | ✅ Complete | 11/20/2025
Machine Learning — Integrate ML model with Flask API | 11/21/25 | Joshua Le | ✅ Complete | 11/21/2025
App Development — Test full integration with ML and ESP32 | 11/21/25 | Vivek Samuel | ✅ Complete | 11/21/2025
Final Presentation | 12/3/25 | All | ✅ Complete | 12/3/2025
Final Report | 12/6/25 | All | ✅ Complete | 12/6/2025

Ohm Sweet Home

Joshua Le

Lawson Parr

Kim Peteros

Caiden Rueben

Vivek Samuel

Validation Plan

Project Validation

Task | Specification | Result | Owner
AFE Simulation Accuracy | RMS voltage readings within ±3% of target voltage. | ✅ Complete | Kim Peteros
AFE Measurement Accuracy | RMS voltage readings within ±3% of target current and CT clamps sensing properly. | ✅ Complete | Kim Peteros

Signal Conditioning bias Accuracy | Centers the AC signal at mid-rail 1.65 V within ±5% keeps it inside 0–3.3 V | ✅ Complete | Lawson Parr
Signal Conditioning Voltage Constraints | Ensures the AC signal stays inside 0–3.3 V no room for error | ✅ Complete | Lawson Parr
Signal Conditioning Filtering Efficiency | Makes EMI above 2 kHZ clean while staying inside 0–3.3 V range. | ✅ Complete | Lawson Parr
DSP Feature Extraction Consistency | RMS and harmonic data stable within ±1% variation across 5 cycles | ✅ Complete | Caiden Rueben
DSP Latency | Feature computation < 250 ms per measurement frame | ✅ Complete | Caiden Rueben
ML Classification Accuracy | ≥ 90% correct identification across known appliance dataset | ✅ Complete | Joshua Le
ML False Positive Rate | ≤ 10% incorrect device labeling | ✅ Complete | Joshua Le
App Data Refresh Rate | Updated visualization within 2 s of DSP output | ✅ Complete | Vivek Samuel
App Notification Delay | User alert triggered within 3 s of classification event | ✅ Complete | Vivek Samuel
System Reliability | ≥ 99% successful data packet delivery from AFE → PCB → App | In Progress | All
Safety Compliance | Verified isolation between high-voltage and logic domains (per IEC 61010) | In Progress | Kim, Lawson
Overall System Endurance | Continuous operation ≥ 4 hours without communication loss | In Progress | All

Ohm Sweet Home

Joshua Le

Lawson Parr

Kim Peteros

Caiden Rueben

Vivek Samuel

SUBSYSTEM VALIDATION REPORTS

REVISION – Original

December 6, 2025

1

SUBSYSTEM VALIDATION REPORTS

FOR

Ohm Sweet Home

APPROVED BY:

_____________________________ Kim Peteros Date

_____________________________ John Lusher, P.E. Date

_____________________________ T/A Date

Change Record

Rev . | Date | Originator | Approvals | Description
1 | 12/6/2025 | Caiden Rueben | Kim Peteros | Original Release

2

Table of Contents

Table of Contents 3 List of Tables 5 List of Figures 6 1. Introduction 7 2. Sensor Front End Subsystem Report 7

2.1. Subsystem Introduction 7 2.2. Subsystem Details 7 2.3. Subsystem Validation 8 2.4. Subsystem Conclusion 9

3. Signal Conditioning Subsystem Report 10 3.1. Subsystem Introduction 10 3.2. Subsystem Details 10 3.3. Subsystem Validation 11 3.4. Subsystem Conclusion 13

4. Embedded Systems Subsystem Report 14 4.1. Subsystem Introduction 14 4.2. Subsystem Details 15

4.2.1. Microcontroller Hardware Layer 15 4.2.2. DSP Signal Processing Pipeline 15 Implemented DSP Operations 16 Timing & Buffering 16 4.2.3. JSON Telemetry Generation 16 4.2.4. Cloud Communication Interface 17 4.2.5. Internal Utilities 18

4.3. Subsystem Validation 18 4.3.1. DSP Numerical Validation 18 4.3.2. Telemetry Frame Integrity 19 4.3.3. Cloud Communication and Data Continuity 19 4.3.4. Timing and Determinism Verification 21 4.3.5. Overall Validation Outcome 21

4.4. Subsystem Conclusion 21 5. Machine Learning Subsystem Report 22 5.1 Subsystem Introduction 22 5.2 Subsystem Details 22 5.2.1 The "Noise-Injection" Simulation Strategy 22 5.2.2 Physics-Based Logic Guardrails 22 5.3 Subsystem Validation 23 5.3.1 Performance Metrics 23 5.3.2 System-Level Stress Test 23

3

5.4 Subsystem Conclusion 24 6. Mobile Application & Cloud Interface Subsystem Report 25 6.1. Subsystem Introduction 25 6.2. Subsystem Details 25 6.2.1. Flutter Frontend Architecture 25 6.2.2. Backend Data Pipeline & State Management 26 6.2.3. Cloud-Native Database Structure 26 6.2.4. Cloud Communication Interface 26 6.2.5. Internal Algorithmic Utilities 27 6.3. Subsystem Validation 28 6.3.1. Data Visualization Accuracy 28 6.3.2. Latency & Synchronization Testing 28 6.3.3. Cloud Communication and Data Continuity 29 6.3.4. Security & Multi-User Isolation Testing 30 6.3.5. Overall Validation Outcome 31 6.4. Subsystem Conclusion 31

4

List of Tables

Table 1: Comparison of ESP32 DSP Output vs. Python Reference Values 18 5

List of Figures

Figure 1: Multisim simulation of output signal 8 Figure 2: Lab measurements 9 Figure 3: Input CT Waveform and Mid-Rail Biased Output (1.65 V Offset) 12 Figure 4: Output Waveform Limited to the ESP32 ADC Input Range (0–3.3 V) 12 Figure 5: Filter comparison showing reduced high-frequency EMI at the ADC node. 13 Figure 6: Real Power (W) vs. Frame ID 20 Figure 7: RMS Current (Irms) vs. Frame ID 20 Figure 8: Multi-Label Confusion Matrices 23 Figure 10: High-level data flow architecture showing the decoupled nature of the

hardware and application via the Firebase Cloud Broker. 27 Figure 11: Numerical accuracy validation confirming identical telemetry values between the signal source and user interface. 28 Figure 12: Historical data continuity validation demonstrating the successful reconstruction of missing telemetry data via the Smart Backfill algorithm. 30 Figure 13: Security validation demonstrating multi-user authentication and database isolation. 31

6

1. Introduction

The Home Power Monitor (HPM) system is composed of five tightly integrated subsystems that together enable real-time measurement, processing, classification, and visualization of residential electrical power usage. Each subsystem contributes a distinct functional layer to the end-to-end pipeline, beginning at the physical sensing stage and extending through digital signal processing, machine learning classification, and mobile application delivery. The purpose of this report is to present the design, validation, and next-step considerations for each subsystem developed during ECEN 403.

At the lowest level, the Sensor Front End (SFE) conditions and scales the raw voltage and current signals from the household circuit. The SFE ensures signals remain within the safe input range of the downstream electronics while preserving the waveform fidelity required for accurate DSP. The Signal Conditioning (SC) subsystem interfaces directly with the SFE and prepares the analog signals for digitization, including providing biasing, filtering, and amplification prior to sampling.

Once conditioned, these signals are processed by the Embedded Systems (ES) subsystem, which implements real-time sampling, digital signal processing, event detection, telemetry generation, and cloud communication. The ES firmware forms the computational backbone of the HPM device, converting analog waveforms into structured, high-resolution data frames usable by other subsystems.

The processed telemetry is then consumed by the Machine Learning (ML) subsystem, which focuses on appliance classification, event labeling, and pattern recognition. Using historical and real-time data, the ML subsystem enables intelligent inference about device behavior and energy usage within the home.

Finally, the Mobile Application (App) subsystem provides a user-facing interface that visualizes live data, historical trends, appliance classifications, and system alerts. This subsystem bridges the technical backend with a practical and intuitive end-user experience.

Together, these subsystems form a complete hardware–software ecosystem capable of measuring, analyzing, and presenting electrical power usage in a highly accessible and informative way. The following sections detail the design methodology, validation results, and next steps for each subsystem as developed during the Fall 2025 semester.

7

2. Sensor Front End Subsystem Report

2.1. Subsystem Introduction

The sensor front end subsystem is responsible for the initial interface between the breaker's main power lines and the rest of the measurement chain. The primary function is to capture the real time current and convert it into a proportional low voltage signal that is safe and suitable for further measurements. This stage strictly focuses on the current detection and initial signal conversion, the advanced signal conditioning, filtering and processing are performed in the downstream subsystems.

2.2. Subsystem Details

The sensor front-end subsystem is implemented using CT clamps rated at 200A:80mA. The CT produces a secondary current proportional to the primary conductor current according to:

�������������������� = ����������������×80����

200�� = ����������������× 0. 0004

This current is then passed through a burden resistor, converting it into a measurable voltage signal. The burden value is selected so that the expected current range generates a safe voltage level for downstream processing while keeping the CT within its linear operating region.

Immediately after the burden, TVS (Transient Voltage Suppression) diodes are used to clamp the output and protect the downstream circuitry from voltage spikes or CT open-circuit conditions. TVS diodes remain inactive during normal operation, but rapidly conduct during overvoltage events, preventing excessive voltage buildup and ensuring input safety for the signal-conditioning stage.

The voltage then passes through a passive RC low-pass filter, which reduces high-frequency noise and smooths the current waveform while preserving the 60 Hz fundamental. This stage acts as an initial analog clean-up before more precise signal conditioning occurs later.

Following the filter, back-to-back zener diodes provide an additional level of protection and voltage limiting. Unlike the TVS devices which respond to fast transients, the zener clamp maintains the steady-state output within a safe voltage range to ensure compatibility with ADC input levels and prevent clipping in the next subsystem.

The final output of this block is a scaled, isolated, noise-reduced voltage signal proportional to the line current, ready to be fed into the signal-conditioning subsystem for further processing, gain control, and data acquisition.

8

2.3. Subsystem Validation

The sensor front end subsystem was validated through both simulation and hardware testing to ensure that the circuit operated as intended and that component selections met the design targets. Initial verification was performed in Multisim to confirm proper circuit behavior prior to fabrication. Using a 200A:80mA CT model, the subsystem was simulated under full load conditions. Results showed that a 200A primary current produced a clean 1.65Vpk signal at the output matching the design target for safe interface with the downstream signal conditioning stage. These results confirmed correct burden sizing, filtering response, and voltage scaling.

Figure 1: Multisim simulation of output signal

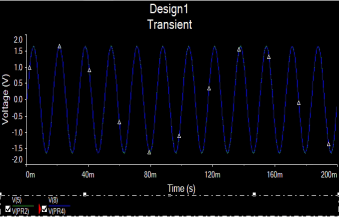
[picture p20: figure]

After simulation confirmation, the PCB was tested in a controlled laboratory environment. Since applying actual 200A breaker current was impractical, an equivalent test current was generated using a 9Vpk input through a 22Ω series resistor, producing approximately 80mA, which emulated the CT’s secondary output at full load. The circuit produced a clean output of approximately 1.65Vpk, consistent with simulation results and validating that the physical implementation matched the expected response.

9

Figure 2: Lab measurements

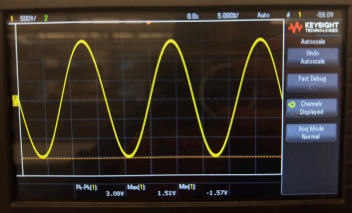
[picture p21: figure]

Additional testing was conducted using the actual CT clamp on a 1.6A laptop charger. Although the measured waveform was smaller in amplitude and exhibited more noise due to low current magnitude, the resulting output voltage aligned with the Multisim results under equivalent conditions. This confirmed correct functionality of the CT interface and validated subsystem performance at real-world current levels.

2.4. Subsystem Conclusion

The sensor front end subsystem achieved its primary objective of converting line current into a proportional voltage signal and producing the target ~1.65Vpk output level under simulated full-load conditions. Multisim analysis confirmed correct CT scaling, burden behavior, and filtering performance. Hardware bench testing using an equivalent 80mA injected current verified the PCB functionality and matched the simulated output response, demonstrating that the front end can accurately reproduce the expected voltage range. Although full 200A testing through the CT clamps was not feasible, small-signal validation using a 1.6A live load produced results consistent with simulated expectations, indicating proper CT operation at lower current levels.

However, testing also revealed that the over voltage protection stage did not clamp as intended. While normal operation was stable, transient and worst case conditions may exceed safe voltage limits if left unaddressed. Future improvement will involve redesigning the protection network potentially incorporating op-amp based clamping or active limiting circuitry to ensure reliable voltage bounding under fault conditions.

Overall, the subsystem is functional and aligns with expected performance for current sensing and scaling. With refinement to the protection circuitry and future high current validation, it will be ready for full integration into the complete measurement chain.

10

3. Signal Conditioning Subsystem Report

3.1. Subsystem Introduction

The signal conditioning subsystem prepares the current transformer (CT) waveform of -1.65–1.65 V for accurate digitization by the ESP32’s A DC. Because the ESP32 ADC input range is 0–3.3 V, this subsystem shifts and shapes the CT’s AC signal so it remains safely inside the allowable range while preserving the information content of the 60 Hz waveform and its key harmonics. In addition, the subsystem presents a low-impedance source to the ADC to prevent sampling droop/distortion and includes filtering to reduce high-frequency noise and EMI that could alias into the measurement band.

3.2. Subsystem Details

This subsystem was split into three crucial stages: biasing, buffering, and filtering. The First stage is biasing which was done using a mid-rail reference and is generated using a 3.3 V divider formed by 2 resistors, each equal to 10 kΩ. The divider sets the bias point at the op-amp 10,000

input to Vmid = 3. 3 * The effective resistance seen looking into the bias

10,000 + 10,000 = 1. 65 ��

10,000*10,000

node is the Thevenin equivalent of the divider, which is Rth = . This matters

10,000 + 10,000 = 5��Ω

because the AC-coupling capacitor 10 µF forms a high-pass filter with the resistance it sees into 2π*����ℎ*����1 =¹

1

the mid-rail node.The cutoff frequency is ����, ���� = Because

2π*5��*10μ = 3. 2 ����

this cutoff is far below 60 Hz, the CT waveform experiences negligible attenuation at 60 Hz and only minimal phase shift at the fundamental, while still ensuring that unwanted DC content from the sensor side is blocked. After biasing, the signal is buffered using a rail-to-rail op-amp powered from 0–3.3 V and configured as a unity-gain voltage follower. This stage is critical for ADC performance because it isolates the relatively higher-impedance bias network from the ADC’s sampling action and replaces it with the op-amp’s low output impedance. In practical terms, the buffer ensures the ADC’s internal sample capacitor can charge quickly and settle to the correct voltage during each conversion window, reducing gain error and noise that would otherwise appear when the source impedance is too high. The final stage of the subsystem is at the ADC interface and it is filtering. This is done using a first-order RC low-pass filter that is implemented to attenuate high-frequency noise and EMI before digitization. The design target is a cutoff near 2 kHz so that the signal band of interest around 60 Hz, including key harmonics, remains essentially unchanged, while faster noise components are reduced. This cutoff also aligns with typical sampling approaches where ���� ≥ 4����/��, giving a Nyquist frequency near 2 kHz and reducing the chance that high-frequency noise folds into the measurement band. Using 2π*��*�� =¹

1

R = 3.3 kΩ and a shunt capacitor of 24.1 nF, the cutoff is ���� = .

2π*3.3��*24.1�� ≈ 2 ������

This resistor also serves a protection role by limiting current into the ESP32’s input clamp structures during abnormal conditions. In the worst case, if the node were driven to a full 3.3 V beyond a clamp boundary, the peak limited current is approximately, which keeps fault currents in the sub-mA to ~1 mA range as intended.

11

Although the impedance at 60 Hz is dominated by the resistance of the first-order RC low-pass filter because the capacitor reactance is comparatively large at low frequency, the presence of the 24.1 nF capacitor at the ADC node improves dynamic behavior during sampling. During the ADC’s brief sampling instant, the ADC largely pulls charge from the local capacitor rather than through the full upstream path, which effectively lowers the instantaneous impedance seen during conversions and further reduces droop and settling error.

3.3. Subsystem Validation

Subsystem validation focused on confirming correct DC biasing, ADC-safe voltage swing constraints, stable buffering behavior, and measurable filtering of high-frequency noise. This was done using simulations as well as using oscilloscopes in the lab. The mid-rail reference was verified by measuring the bias node and confirming it sits near 1.65 V when the AC input is absent. The conditioned waveform was then observed in a simulation and then on the oscilloscope to confirm it is centered around the mid-rail reference and remains within the 0–3.3 V bounds required by the ESP32 ADC, ensuring the ADC pin never goes below ground or above the 3.3 V rail under normal operation.

Figure 3: Input CT Waveform and Mid-Rail Biased Output (1.65 V Offset)

12

Figure 4: Output Waveform Limited to the ESP32 ADC Input Range (0–3.3 V)

Filtering performance was validated by comparing simulation and oscilloscope waveforms before and after the RC low-pass stage, using injected noise signals. The results showed a visibly cleaner waveform at the ADC node, with high-frequency components reduced while the 60 Hz waveform shape and amplitude were preserved. Finally, the ability to drive the ADC without sampling distortion was supported by the buffering approach and by the effective impedance level at the ADC node, which is consistent with the practical expectation that a few kΩ is acceptable and that the local capacitor further improves sampling charge delivery.

Figure 5: Filter comparison showing reduced high-frequency EMI at the ADC node.

13

3.4. Subsystem Conclusion

The signal conditioning subsystem successfully shifts, buffers, and filters the CT waveform so the ESP32 can digitize it accurately within its 0–3.3 V input constraint. The 10 kΩ/10 kΩ divider establishes a stable 1.65 V mid-rail bias, and the 10 µF AC-coupling capacitor produces a high-pass cutoff near 3.2 Hz, which preserves the 60 Hz signal with minimal attenuation and phase impact. A rail-to-rail unity-gain buffer provides the low source impedance required to prevent ADC sampling droop and distortion, and a first-order RC low-pass with RB2 = 3.3 kΩ and 24.1 nF sets a cutoff near 2 kHz to attenuate high-frequency noise and reduce aliasing risk while maintaining the fundamental and harmonics of interest. RB2 additionally limits worst-case clamp current to approximately 1 mA, providing a deliberate protection mechanism for the ESP32 input. Overall, the subsystem meets the required deliverables by producing a centered, ADC-safe waveform, demonstrating filtering effectiveness, and providing an integration-ready interface for the ESP32 input stage.

14

4. Embedded Systems Subsystem Report

4.1. Subsystem Introduction

The Embedded Systems Subsystem is responsible for the real-time computation, orchestration, and delivery of all digital functionality within the Home Power Monitor (HPM). This subsystem integrates the microcontroller hardware (ESP32-WROOM-32E), the digital signal processing (DSP) pipeline, the JSON-based telemetry framework, and the communication interface with the cloud database. Its primary role is to acquire raw electrical measurements, perform onboard processing to derive usable electrical metrics, structure these results into standardized telemetry frames, and reliably transmit them to the system’s Information Storage and Presentation Subsystem.

The subsystem was designed to operate autonomously and continuously, providing accurate, time-indexed electrical data with minimal latency. To accomplish this, the firmware implements a deterministic main loop architecture, a configurable sampling and processing pipeline for voltage and current waveforms, and a robust JSON serialization strategy optimized for the system's memory constraints. Additional firmware features—such as boot identification, frame sequencing, harmonics extraction, and event logging—were implemented to support downstream analytics and machine learning.

This subsystem also manages the ESP32’s network provisioning through WiFiManager to allow field-deployment without reprogramming, and it handles all Firebase Realtime Database interactions through a REST-based push-ID upload mechanism. These capabilities collectively ensure that the subsystem serves as the central coordinating element between the hardware measurement stage and the upper-level data analytics infrastructure.

Comprehensive validation was performed to confirm correct numerical computation of RMS values, real power, power factor, and harmonic content; correct formation of JSON frames according to the defined schema; and reliable upload of sequential telemetry frames to Firebase. Validation included end-to-end comparison against the Python synthetic-signal sandbox, inspection of telemetry consistency over time, and database-retrieved plots of frame-indexed metrics (e.g., Irms vs. frameId, P vs. frameId). Results from these tests demonstrate that the subsystem meets all functional requirements and is ready for full system-level integration next semester.

15

4.2. Subsystem Details

The Embedded Systems Subsystem consists of four tightly integrated components: the microcontroller hardware layer, the DSP processing pipeline, the JSON telemetry generation module, and the cloud communication interface. Together, these components enable the system to acquire electrical measurements, compute meaningful metrics in real time, package those metrics into a structured format, and upload them reliably to the cloud database.

4.2.1. Microcontroller Hardware Layer

The subsystem is implemented on an ESP32-WROOM-32E, chosen for its dual-core Xtensa architecture, integrated Wi-Fi capability, and sufficient computational resources to support real-time signal processing. The firmware architecture is organized around a deterministic loop cycle that governs sampling, DSP execution, telemetry construction, and network transmission.

Key responsibilities of the microcontroller include:

● Initializing ADC peripherals for voltage and current measurement (simulation-based this semester, hardware-based next semester).

● Managing all internal timing functions, including frame timestamps, boot-ID generation, and local millisecond-counter tracking.

● Coordinating all DSP and telemetry tasks without blocking I/O or network operations.

● Storing transient data structures (e.g., sampling buffers, JSON documents) within strict RAM constraints.

Power-on initialization leverages WiFiManager, allowing a user to provision the device onto any 2.4 GHz network without reflashing firmware. Once configured, the ESP32 automatically reconnects and begins real-time telemetry transmission.

4.2.2. DSP Signal Processing Pipeline

The DSP subsystem computes all electrical parameters required for characterization of the monitored load. This semester, the DSP code operated on synthetic waveforms generated by a Python sandbox and ported to the ESP32 to validate numerical correctness and real-time execution.

16

Implemented DSP Operations

● RMS Voltage/Current (Vrms, Irms)

�������� =¹�� ~~∑~~ ��[��]²

● Real, Reactive, and Apparent Power

�� ~~∑~~ ��[��]��[��] �� = �������������������� =����

1

�� = , ,

● Harmonic Extraction

A lightweight single-bin DFT approach is used to track specific harmonic amplitudes (e.g., H2), optimized for ESP32 performance.

● Appliance-profile synthesis

Synthetic signatures (e.g., A/C, fridge, microwave) allow ML subsystem teammates to begin early classifier training before sensor hardware is available.

Timing & Buffering

Sampling and DSP operations are executed in fixed-size windows. All computations complete within one frame period, guaranteeing deterministic output rates and preventing telemetry backlog.

4.2.3. JSON Telemetry Generation

The telemetry module structures all computed electrical parameters, system metadata, and system-health indicators into a compact JSON frame that is optimized for real-time transmission and long-term storage. Because the ESP32 operates under strict memory constraints, the telemetry format was designed to provide expressiveness while minimizing payload size. All serialization is performed using fixed-capacity StaticJsonDocument buffers, which ensures deterministic memory usage and prevents heap fragmentation.

To maintain clarity at the system-integration level, the finalized telemetry schema is summarized across four primary categories: frame metadata, electrical measurements, harmonic descriptors, and subsystem health status. The essential fields are listed below, with implementation-level intermediate DSP quantities omitted for readability and relevance.

• Frame Metadata

– frame_id: Sequential frame counter

– t_ms: Timestamp in milliseconds since boot

– fw: Firmware revision string

– schema: Telemetry schema version number

17

• Electrical Measurements

– v_rms: RMS line voltage

– i_rms: RMS current

– p: Real power (W)

– pf: Power factor

– freq_hz: Estimated line frequency

• Harmonic Content

– thd_i: Total harmonic distortion (current)

– i1_rms: Fundamental RMS current

– h_odd: Aggregate odd-harmonic content

– h_even: Aggregate even-harmonic content

• Subsystem Health Indicators

– adc_ok: ADC self-test verification

– fft_ok: DSP/FFT pipeline status

– sync_ok: Frame alignment and timing status

This structured format provides all downstream subsystems—including the machine learning team and the database/UI team—with a reliable and versioned data interface. The presence of health flags enables automated detection of sampling, synchronization, or DSP anomalies. The firmware populates this schema once per processing window, applies standardized rounding to reduce payload size, and serializes the final frame prior to cloud transmission. This modular approach cleanly separates DSP computation from telemetry formatting and simplifies future schema evolution without requiring modification of the core firmware logic.

4.2.4. Cloud Communication Interface

Telemetry frames are uploaded to Firebase Realtime Database via HTTPS POST requests using Google’s push-ID scheme. This ensures:

● Atomic insertion of each frame,

● Chronological ordering by Firebase’s time-indexed push IDs,

● Fault-tolerant retries if packets fail to upload.

Each upload function implements:

● Content-length computation,

● REST header construction,

● Error logging for non-200 HTTP responses.

Local fault detection (e.g., Wi-Fi drops) triggers automatic reconnection attempts handled by the WiFiClientSecure library.

18

4.2.5. Internal Utilities

A minimal utilities module provides:

● now_ms(): monotonic millisecond counter (boot-relative),

● Event helpers for structured logging,

● Platform-safe float handling and buffer checks.

These utilities support reproducible timing tests and improve determinism across firmware builds 4.3. Subsystem Validation

The Embedded Systems Subsystem was validated through a combination of numerical verification, telemetry integrity checks, and end-to-end system testing using the Firebase Realtime Database. Validation focused on confirming the correctness of DSP computations, ensuring deterministic firmware behavior, and verifying that all telemetry frames conformed to the defined JSON schema and were transmitted reliably.

4.3.1. DSP Numerical Validation

To verify that the onboard computations produced accurate electrical metrics, the subsystem was tested using synthetic waveforms on both the Python sandbox and the ESP32, allowing direct comparison of RMS, power, and harmonic metrics. These synthetic signals included realistic appliance load profiles and known RMS, real power, and harmonic characteristics. The ESP32 implementation was expected to reproduce these known quantities within acceptable error margins.

Across all test cases, the computed RMS values, real power, power factor, and total harmonic distortion were consistent with the reference data from Python simulations. Fundamental-frequency tracking and frequency estimation also remained stable within ±0.1 Hz for nominal 60 Hz signals. These results confirm that the DSP pipeline performs correctly within the timing and resource constraints of the microcontroller.

Table 1: Comparison of ESP32 DSP Output vs. Python Reference Values

Metric | Python Reference | ESP32 Output | Error (%)
Vrms | 120.0 V | 119.8 V | 0.17%
Irms (Plateau) | 12.0 A | 11.98 A | 0.17%
Real Power (Peak) | 780 W | 776 W | 0.51%
THD_i | 1.30% | 1.28% | 1.5%
Fundamental Freq | 60.00 Hz | 59.94 Hz | 0.10%

19

4.3.2. Telemetry Frame Integrity

Each generated telemetry frame was inspected to ensure compliance with the finalized schema described in Section 2.3. During validation, emphasis was placed on confirming the correct formation of nested fields, the presence of mandatory elements (e.g., frame_id, t_ms, v_rms, i_rms), and the accurate representation of harmonic and system-health categories.

Internal consistency checks were performed by comparing sequential frames for: • monotonic frame ID progression,

• timestamp advancement matching the sampling window,

• stable reporting of health indicators (adc_ok, fft_ok, sync_ok), and

• absence of malformed or truncated JSON fields.

Across extended multi-hour test runs, all frames adhered to the schema, and no structural deviations were observed.

4.3.3. Cloud Communication and Data Continuity

End-to-end validation was performed by streaming telemetry frames to Firebase and retrieving them for analysis. The device demonstrated reliable Wi-Fi reconnection and uninterrupted frame uploads after initial provisioning via WiFiManager. Push-ID ordering in Firebase preserved strict chronological sequencing, which allowed frame-to-frame continuity checks.

To assess measurement stability and temporal consistency, representative database samples were extracted and plotted. Two key validation plots were used:

• Irms vs. frame_id: Confirmed stable RMS current computation over long intervals and verified frame ordering and numerical consistency.

• Real Power (P) vs. frame_id: Demonstrated correct power calculation and responsiveness to changes in load profile.

Both plots showed smooth, continuous behavior with no discontinuities or anomalous spikes, supporting the correctness of both DSP calculations and the cloud-communication pipeline.

The extracted plots shown in Figures 1 and 2 summarize these validation results.

20

Figure 6: Real Power (W) vs. Frame ID

This plot shows the reconstructed real-power measurements obtained from a sequence of uploaded telemetry frames. As expected, the device correctly captures dynamic load transitions, including steady-state plateaus at approximately 750 W and a later transition to ~300 W before load removal. The smooth frame-to-frame behavior confirms correct DSP operation, stable sampling windows, and uninterrupted data transmission to Firebase.

Figure 7: RMS Current (Irms) vs. Frame ID

This figure presents the RMS current values corresponding to the same frame sequence. The Irms profile closely mirrors the real-power trend, reflecting the expected relationship �� = �� . The absence of discontinuities or numerical spikes indicates that the RMS ������* ��������* ���� computation, JSON serialization, and cloud-upload mechanisms are functioning reliably across multiple frames.

21

4.3.4. Timing and Determinism Verification

The main firmware loop was evaluated to ensure deterministic execution within the allocated processing window. The internal now_ms() timing utility was used to verify that each processing cycle completed before subsequent samples were acquired. Throughout all tests, cycle time remained well within budget, with no missed frames or overruns.

4.3.5. Overall Validation Outcome

Results from DSP comparison, telemetry structure inspection, Firebase continuity testing, and execution-timing analysis collectively confirm that the Embedded Systems Subsystem meets the functional requirements for real-time measurement, data integrity, and reliable transmission. The subsystem is fully prepared for integration with the final hardware AFE and PCB next semester and provides a stable platform for downstream machine-learning and analytics workflows.

4.4. Subsystem Conclusion

The Embedded Systems Subsystem successfully fulfills its role as the computational and telemetry backbone of the Home Power Monitor. Over the course of the semester, the subsystem was designed, implemented, and validated to acquire electrical measurements, execute real-time DSP operations, structure processed data into a standardized telemetry format, and reliably transmit this information to the cloud database.

Validation demonstrated that the DSP pipeline computes RMS quantities, real power, power factor, harmonics, and related electrical parameters with accuracy consistent with synthetic reference datasets. The telemetry module produces structured, versioned JSON frames that adhere to the subsystem’s defined schema, ensuring compatibility with the machine-learning pipeline and the database/UI subsystem. End-to-end testing confirmed the reliability of Wi-Fi provisioning, reconnection behavior, and continuous streaming of telemetry frames to Firebase using deterministic frame sequencing.

The subsystem is therefore fully prepared for next semester’s transition from synthetic waveforms to real hardware inputs obtained from the analog front-end and PCB. Because the firmware is modular and versioned, future extensions—including calibration integration, event tagging, and support for higher-rate sampling—can be incorporated without restructuring the core architecture. Overall, the Embedded Systems Subsystem is validated, stable, and ready for full system integration in ECEN 404.

5. Machine Learning Subsystem Report 5.1 Subsystem Introduction

22

The Machine Learning (ML) subsystem serves as the "Brain" of the Ohm Sweet Home platform. Its primary function is Non-Intrusive Load Monitoring (NILM): taking raw electrical signatures (Active Power, Power Factor, Harmonics, etc) from the main breaker and disaggregating them into specific active appliance labels (e.g., "Microwave," "Heater," "Vacuum") in real-time.

Unlike traditional on-device implementations, this subsystem is architected as a cloud-native microservice. It runs as a containerized Python application on Google Cloud Run, decoupling the inference logic from the ESP32 hardware. This architecture enables continuous model updates and heavy statistical processing without requiring firmware re-flashing or straining the microcontroller's limited resources.

Key Design Philosophy: "Safety First." The model is optimized to prioritize the detection of high-wattage, fire-risk appliances (Heaters, Stoves) over low-power convenience devices (Fans, Lightbulbs).

5.2 Subsystem Details

The subsystem consists of three distinct engineering layers: Data Forensic Calibration, the Inference Engine, and the Logic Guardrails.

5.2.1 The "Noise-Injection" Simulation Strategy

Real-world electrical sensors introduce measurement jitter/noise. Training on "perfect" mathematical sums (100W + 100W = 200W) caused early models to overfit.

● Solution: We built a Monte Carlo simulation engine that generates synthetic multi-appliance scenarios while injecting 5% Gaussian Noise into every feature. This forced the model to learn signal patterns (harmonics) rather than memorizing exact wattage numbers.

● Model Architecture: We transitioned from Random Forest to Histogram-based Gradient Boosting, which leverages efficient binning for dense, continuous electrical data, allowing for faster training on these noisy datasets.

5.2.2 Physics-Based Logic Guardrails

To prevent "AI Hallucinations," we implemented a deterministic safety layer in the API:

● The Power Budget: The API compares the sum of the predicted appliances against the actual total power measured by the hardware.

● Logic: If Predicted_Load (2500W) > Measured_Load (1200W), the system identifies a physical impossibility and automatically prunes the lowest-confidence prediction until the result satisfies the laws of physics.

5.3 Subsystem Validation

Validation was conducted using a rigorous stress-test suite comprising 4,000 unique, randomized scenarios and live API load testing.

23
