OPbagelBites/ECEN404-2026SP-Home-Power-Monitor-2/docs/Presentations/TA Update 2.pptx

## OHM Sweet Home

Weekly Update 2

## SFE/Signal Conditioning/Embedded Systems

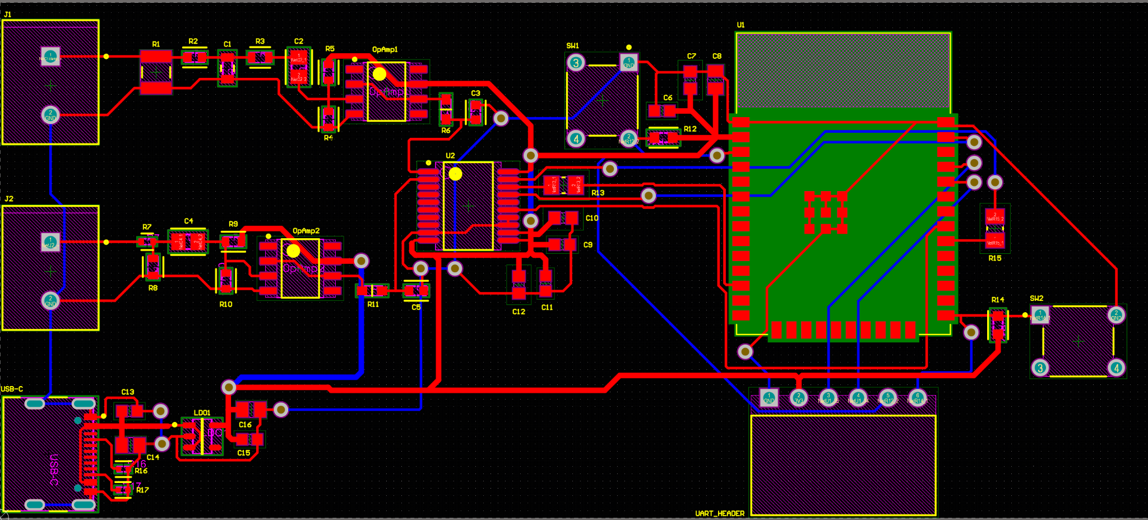
[picture p66: figure]

Completed:
- Finished schematic designs
- Completed PCB design
- Addition of Voltage Sensing
- Added external ADC
In Progress:
- Waiting for PCB approval
- Part Order

## Machine Learning

Completed:
- Setup Google Cloud Run
In Progress:
- Verifying the flow of data from ESP -> Cloud -> Database

## Application Development

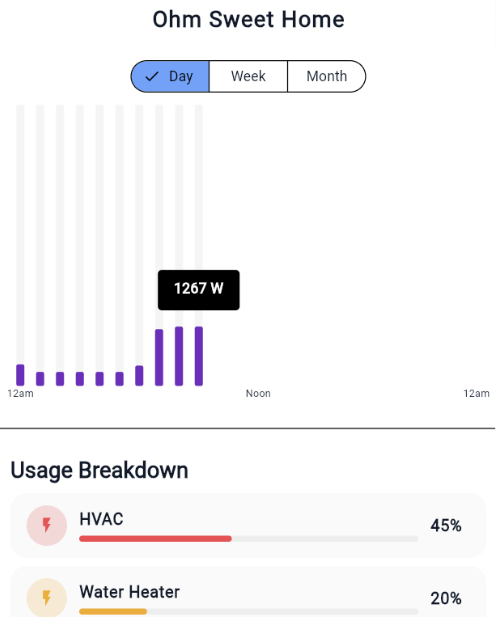
[picture p67: figure]

Completed: Fixed Backfill Algorithm so the charts don't have empty space in the history char
In Progress: Make it look nicer, work with microcontroller
