OPbagelBites/ECEN404-2026SP-Home-Power-Monitor-2/docs/Presentations/TA Update 3.pptx

## OHM Sweet Home

Weekly Update 2

## SFE/Signal Conditioning/Embedded Systems


Completed:
- Finished schematic designs
- Completed PCB design
- Addition of Voltage Sensing
- Added external ADC
- Designed and ordered the PCB
In Progress:
- Putting PCB together

## Machine Learning

Completed:
- Setup Google Cloud Run
In Progress:
- Verifying the flow of data from ESP -> Cloud -> Database

## Application Development


Completed: Fixed Backfill Algorithm so the charts don't have empty space in the history char
In Progress: Make it look nicer, work with microcontroller
