OPbagelBites/ECEN404-2026SP-Home-Power-Monitor-2/docs/ESP32_WROOM32E_ADS131M04_PinMapping.pdf

# Pin Mapping and Integration Guide

MCU: Espressif ESP32-WROOM-32E (Module)
Dev Kit Used for Development: ESP32-DevKitC-32E
External ADC: Texas Instruments ADS131M04IPWT (4-Ch, 24-bit Delta-Sigma)

## Overview

This document provides the pin mapping and connection details between the ESP32-WROOM-32E and the ADS131M04 external ADC. It is focused on the MCU and ADC interface only, and intended to serve as a direct reference for PCB design.

## ESP32 ↔ ADS131M04 Core Signals

Function | ESP32 Signal | ESP32 GPIO | Notes | ADS131M04 Pin
SPI SCLK | VSPI SCLK | GPIO18 | 50–80 Ω series resistor near ESP32 | SCLK
SPI MOSI | VSPI MOSI | GPIO23 | DIN on ADS; series resistor near ESP32 | DIN
SPI MISO | VSPI MISO | GPIO19 | DOUT from ADS; series resistor near ADS | DOUT
SPI CS | VSPI CS0 | GPIO5 | Pull-up 10 kΩ to 3V3 optional | /CS
Data Ready | DRDY (INT) | GPIO34 | Input-only; interrupt line | /DRDY
Sync/Reset | SYNC/RESET | GPIO25 | Soft reset/sync; pull-up 10 kΩ to 3V3 | /SYNC
ADC Clock In | - | External XO | 8.192 MHz osc → CLKIN; not from ESP32 | CLKIN

## Analog Front End (AFE) Channel Usage

Channel | Use | Topology | Notes
CH1 (AIN0P/AIN0N) | Line 1 Current (CT) | Differential | Burden resistor sized for ±0.9 Vpk diff; RC anti-alias (e.g., 100 Ω + 1 µF)
CH2 (AIN1P/AIN1N) | Line 2 Current (CT) | Differential | Same as CH1; keep pair tightly coupled and symmetric
CH3 (AIN2P/AIN2N) | Voltage (L1) | Divider/PT → differential | Use PT or divider with protection; target ±0.9 Vpk diff
CH4 (AIN3P/AIN3N) | Voltage (L2 or Neutral Ref) | Divider/PT → differential | Same as CH3; can be used as neutral-ref channel

## ESP32 System Pins (for Bring-up)

Function | ESP32 GPIO | Notes
EN (Reset) | EN (module pin) | Pull-up 10 kΩ to 3V3; test pad required
BOOT (IO0) | GPIO0 | Leave free for download mode; test pad or jumper
UART0 TX | GPIO1 | Programming header; 3V3 logic
UART0 RX | GPIO3 | Programming header; 3V3 logic

Function | ESP32 GPIO | Notes
Status LED | GPIO4 | Safe choice; GPIO2 is strap-sensitive
User Button | GPIO13 | Pull-up 10 kΩ; optional for testing

## Notes for PCB Designer

- Keep ESP32 antenna region free of copper and tall components.
- Provide ≥500 mA headroom on 3.3 V rail.
- Use ferrite bead to split 3V3A (analog) and 3V3D (digital).
- Place RC anti-alias filters at ADC pins.
- Provide 6-pin programming header (3V3, GND, U0TXD, U0RXD, EN, IO0).
