OPbagelBites/ECEN404-2026SP-Home-Power-Monitor-2/docs/Reports/Execution_Plan_Timeline.xlsx

Task | 2026-01-26 | 2026-02-02 | 2026-02-09 | 2026-02-16 | 2026-02-23 | 2026-03-02 | 2026-03-09 | 2026-03-16 | 2026-03-23 | 2026-03-30 | 2026-04-06 | Owner | Date Completed
Finalize scaled SFE (1–5A) | Done |  |  |  |  |  |  |  |  |  |  | Kim | 2026-01-22
Finalize signal conditioning | Done |  |  |  |  |  |  |  |  |  |  | Lawson | 2026-01-22
Firmware DSP → JSON pipeline | Done |  |  |  |  |  |  |  |  |  |  | Caiden | 2026-01-23
App live telemetry display | In Progress | In Progress | In Progress | In Progress | Done |  |  |  |  |  |  | Vivek | 2026-02-20
PCB bring-up & bench validation | In Progress | In Progress | In Progress | In Progress | Behind |  |  |  |  |  |  | Kim, Lawson, Caiden
ML inference integration |  | In Progress | In Progress | In Progress | Done |  |  |  |  |  |  | Joshua | 2026-02-20
End-to-end system integration |  |  |  |  | Behind |  |  |  |  |  |  | Full Team
System-level validation |  |  |  |  |  |  |  |  |  |  |  | Full Team
Stress & endurance testing |  |  |  |  |  |  |  |  |  |  |  | Full Team
Final demo prep + documentation |  |  |  |  |  |  |  |  |  |  |  | Full Team
ML inference integration
Task | 2026-01-26 | 2026-02-02 | 2026-02-09 | 2026-02-16 | 2026-02-23 | 2026-03-02 | 2026-03-09 | 2026-03-16 | 2026-03-23 | 2026-03-30 | 2026-04-06 | Owner | Date Completed
Finalize scaled SFE (1–5A) | Done |  |  |  |  |  |  |  |  |  |  | Kim | 2026-01-22
Finalize signal conditioning | Done |  |  |  |  |  |  |  |  |  |  | Lawson | 2026-01-22
Firmware DSP → JSON pipeline | Done |  |  |  |  |  |  |  |  |  |  | Caiden | 2026-01-23
App live telemetry display | In Progress | In Progress | In Progress | In Progress | Done |  |  |  |  |  |  | Vivek | 2026-02-20
PCB bring-up & bench validation | In Progress | In Progress | In Progress | In Progress | Behind | Behind | Done |  |  |  |  | Kim, Lawson, Caiden | 2026-03-09
ML inference integration |  | In Progress | In Progress | In Progress | Done |  |  |  |  |  |  | Joshua | 2026-02-20
End-to-end system integration |  |  |  |  | Behind | Behind | Done |  |  |  |  | Full Team | 2026-03-09
System-level validation |  |  |  |  |  |  | In Progress | In Progress | In Progress | In Progress | Done | Full Team | 2026-04-01
Stress & endurance testing |  |  |  |  |  |  | In Progress | In Progress | In Progress | In Progress | Done | Full Team | 2026-04-01
Final demo prep + documentation |  |  |  |  |  |  |  |  |  |  | Done | Full Team | 2026-04-20
