OPbagelBites/ECEN404-2026SP-Home-Power-Monitor-2/Machine_Learning/feature_importance.png

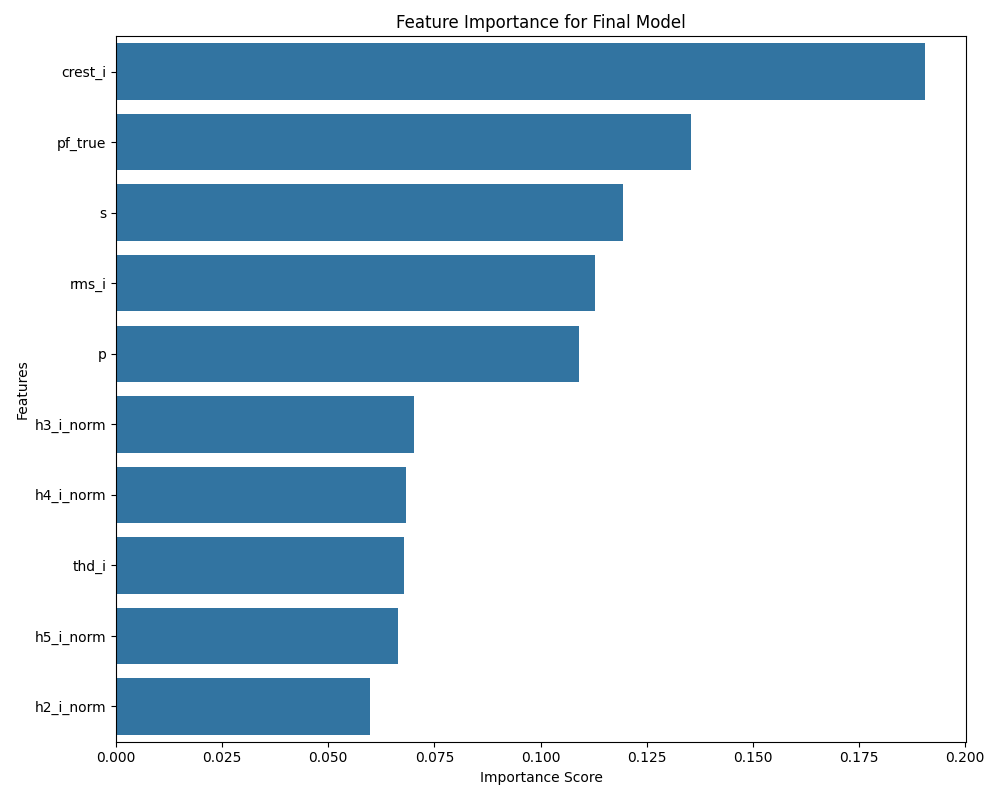
Machine_Learning/feature_importance.png
