OPbagelBites/ECEN404-2026SP-Home-Power-Monitor-2/Machine_Learning/models/confusion_matrix_multi.png

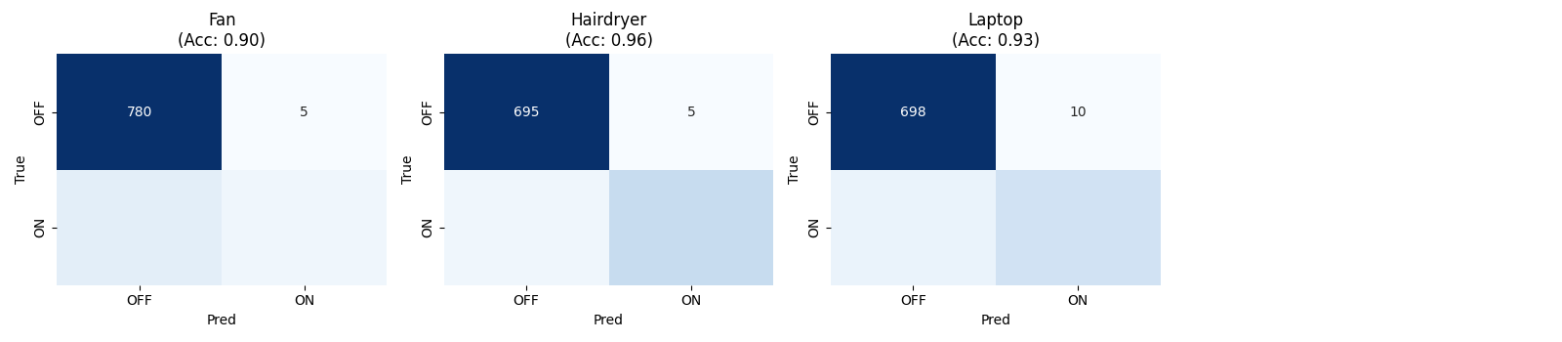
Machine_Learning/models/confusion_matrix_multi.png
