OPbagelBites/ECEN404-2026SP-Home-Power-Monitor-2/Machine_Learning/threshold_curve_Heater.png

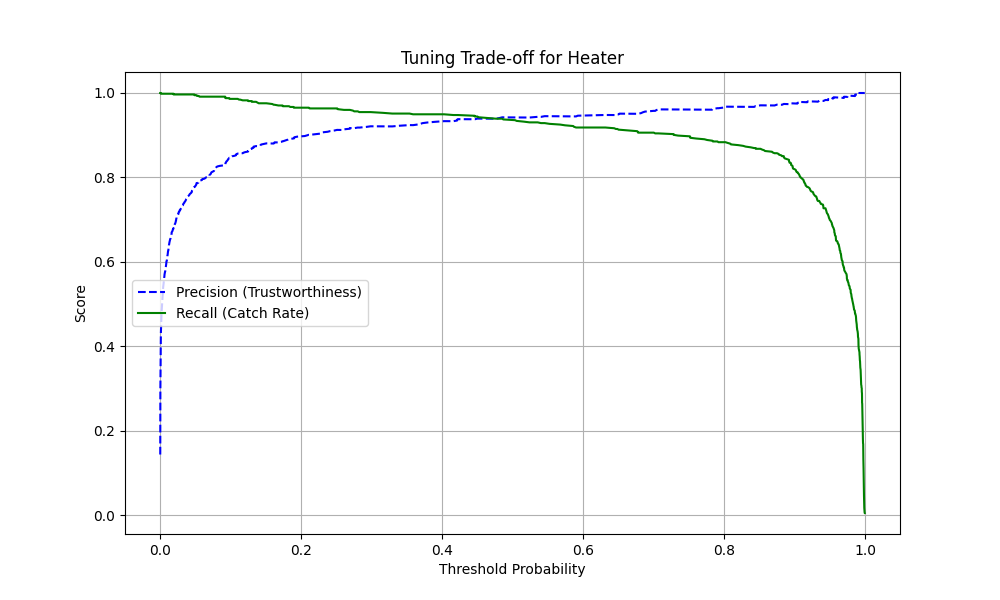
Machine_Learning/threshold_curve_Heater.png
