OPbagelBites/ECEN404-2026SP-Home-Power-Monitor-2/docs/Capstone_Budget_Tracker.xlsx

Part Name | Part Number | Part Description | Price ($)
ESP32-DEVKITC-32E |  | MCU dev kit for embedded systems demo | $17.99
Kims PCB |  | SFE Front End PCB | $139.41
Lawsons PCB |  | Signal Processing PCB | $139.41
Kims DIGIKEY |  | Components for PCB | $19.10
Lawsons DIGIKEY | 1276-6456-1-ND | CAP CER 10UF 10V X5R 0805 | $0.20
 | 311-10.0KHRCT-ND | RES 10K OHM 1% 1/10W 0603 | $0.40
 | 311-10.0KHRCT-ND | RES 10K OHM 1% 1/10W 0603 | $0.06
 | WM4111-ND | CONN HEADER VERT 2POS 2.54MM | $1.44
 | 296-34414-5-ND | IC OPAMP GP 1 CIRCUIT 8SOIC | $4.68
 | 311-3.30KHRCT-ND | RES 3.3K OHM 1% 1/10W 0603 | $0.22
 | 1276-1104-1-ND | CAP CER 0.022UF 50V X7R 0603 | $0.20
Kims DIGIKEY V.2 |  | Components for Final PCB | $10.18
CT clamp x2 |  | 5A:0.5A CT clamp | $37.30
PCB order |  | Final PCB | $139.41
Caidens Mouser |  | Caidens external ADC | $23.82
Caidens Mouser 2 |  | ESP - 32 | $5.09
Mouser 3 |  | More USB-C headers | $9.75
Caidens Mouser 4 |  | transformer | $25.83
