OPbagelBites/ECEN404-2026SP-Home-Power-Monitor-2/docs/Reports/FSR_Validation_Matrix.xlsx

Task | Source (FSR §) | Specification | Methodology | Result | Owner
AFE Simulation Accuracy | FSR 3.2.1.1 | RMS voltage & current error ≤ ±2% | Multisim simulation vs reference | Complete | Kim Peteros
AFE Measurement Accuracy | FSR 3.2.1.1 | RMS voltage & current error ≤ ±2% | Oscilloscope + DMM comparison | Complete | Kim Peteros
Signal Conditioning Bias | FSR 3.2.3.3 | ADC Mid-rail bias 1.65 | Multimeter bias verification | Complete | Lawson Parr
Signal Conditioning Bias | FSR 3.2.3.3 | ADC Input Voltage Range 0–3.3 V | Oscilloscope range verification | Complete | Lawson Parr
Signal Conditioning Filter | FSR 3.2.3.3 | Signal bandwidth ≤ 2 kHz, no clipping | Noise injection + ADC check | Complete | Lawson Parr
Signal Conditioning PCB Validation | FSR 3.2.3.3 | Valid ADC drive within limits | Oscilloscope validation | Complete | Lawson Parr
DSP Feature Extraction Consistency | FSR 3.2.1.1, 3.2.1.4 | RMS + harmonics stable within ±1% | Compare successive DSP frames | Complete | Caiden Rueben
DSP Latency | FSR 3.2.1.7 | End-to-end latency ≤ 3 s | Timestamp measurement | Complete | Caiden Rueben
ML Classification Accuracy | FSR 3.2.1.6 | ≥ 85% correct identification | Validation dataset test | Complete | Joshua Le
ML False Positive Rate | FSR 3.2.1.6 | ≤ 15% misclassification | Precision/recall analysis | Complete | Joshua Le
App Data Refresh Rate | FSR 3.2.1.7 | Display update ≤ 3 s | DSP→App timing test | Complete | Vivek Samuel
App Notification Delay | FSR 3.2.1.7 | Alert latency ≤ 3 s | Timed notification test | Complete | Vivek Samuel
System Reliability | FSR 3.2.5.1 | ≥ 99% packet delivery success | Packet loss measurement | Complete | Caiden Rueben
Safety Compliance | FSR 3.2.3.4 | Isolation between HV and logic | Isolation & continuity test | Complete | Kim Peteros
Overall System Endurance | FSR 3.2.5 | Continuous operation ≥ 30 minutes | Extended runtime test | Complete | All
End-to-End Telemetry Flow | FSR 3.1, 3.2.1.5 | JSON telemetry ≥ 1 Hz | Verify full data path | Complete | All
Concurrent Device Detection | FSR 3.2.1.6 | Detect ≥ 2 devices | Simultaneous load test | Complete | All
User Device Training Workflow | FSR 3.2.1.6 | New device recognized after training | Training workflow test | Complete | Joshua Le
Historical Data Recall | FSR 3.2.5.2.2 | Logs persist after restart | Power cycle verification | Complete | Caiden Rueben
Fault Detection & Recovery | FSR 3.2.5.2 | Fault detected ≥ 95% | ADC/Wi-Fi fault injection | Complete | Caiden Rueben
Full System Testing | FSR 3.2.5.2.1 | ≥ 95% correct sensing and classification | Test using household appliances, verify waveform capture | Complete | All
Wi-Fi Reconnection | FSR 3.2.5.2.2 | Auto reconnect after drop | Router disable/enable | Complete | Caiden Rueben
Stress Load Latency | FSR 3.2.1.7 | Latency ≤ 3 s with ≥2 devices | Multi-load stress test | Complete | Joshua Le
Power Cycle Data Integrity | FSR 3.2.5.2.2 | No data loss after reboot | Reboot and verify logs | Complete | All
