OPbagelBites/ECEN404-2026SP-Home-Power-Monitor-2/(list of files, drawings)

Other design files:
Altium_Project.PrjPcb/404Final.PrjPcb
Altium_Project.PrjPcb/MCU.SchDoc
Altium_Project.PrjPcb/PowerRegulator.SchDoc
Altium_Project.PrjPcb/SFE_SC.SchDoc
