OPbagelBites/ECEN404-2026SP-Home-Power-Monitor-2/firmware/include/telemetry.h

#ifndef TELEMETRY_H
#define TELEMETRY_H

#include <Arduino.h>

struct FrameCore {
  float vrms, irms, P, S, PF_true;
  float v1_rms, i1_rms, phi_deg, P1, Q1, S1, PF_disp;
  float thd_i, thd_v, odd_sum_i, even_sum_i, crest_i, form_i;
};

// Writes the frame JSON into an existing JsonDocument (caller owns capacity).
// harm_ratio[k] = ratio at k*f0 relative to fundamental, for k=2..kmax.
#include <ArduinoJson.h>
void pack_frame_json(
  JsonDocument& doc,
  uint64_t t_ms, uint32_t frame_id, float fs, uint32_t N, const char* window_name, float f0_hz,
  const FrameCore& core,
  const float* harm_ratio, int kmax,
  const char* state,
  float d_irms, float d_p,
  bool fft_ok=true, bool sync_ok=true, bool adc_ok=true,
  const char* fw="fw-esp-0.1.0",
  const char* cal_id="cal-default"
);

#endif // TELEMETRY_H
