OPbagelBites/ECEN404-2026SP-Home-Power-Monitor-2/(commit log)

2025-10-07 Build Skeleton Pre Board
2025-10-21 Event Emission/Summary line
    Added a summary line in the JSON file and an Event Emission logic chain.
2025-11-14 Firebase Continuation Fix
    Made it so on ESP32 restart, it didn't rewrite nodes starting from 0, but instead picked up where it left off.
    [config.h, firebase.cpp, main.cpp, telemetry.h]
2025-11-18 Add ML code without large model artifacts
    [1.csv, 10.csv, 100.csv, 1000.csv, 1001.csv, 1002.csv, 1003.csv, 1004.csv]
2025-11-18 Changed seconds per frame to 3
2026-02-06 HUGE CHANGES
    HUGE CHANGES
    [1074.csv, 114.csv, 115.csv, 116.csv, 117.csv, 118.csv, 160.csv, 161.csv]
2026-02-19 HDM
    Added Hardware mode for PCB
2026-03-11 Current calibration 1
2026-03-20 Issue with zeros but progress
    [config.h, main.cpp]
2026-03-20 Power Readings working with no load
2026-04-20 Added Altium Files
    [404Final.PrjPcb, MCU.SchDoc, PowerRegulator.SchDoc, SFE_SC.SchDoc]
2026-04-22 Machine Learning
    [pyvenv.cfg]
2026-04-28 Add docs folder
    [Capstone_Budget_Tracker.xlsx, Execution_Plan_Timeline.xlsx, FSR_Validation_Matrix.xlsx]
